ibrahimnasrum/automatic-waste-segregation/Report And Slide/Slide2(Final)_Automatic_Waste_Segregation(INTEGRATED_DESIGN_PROJECT).pdf

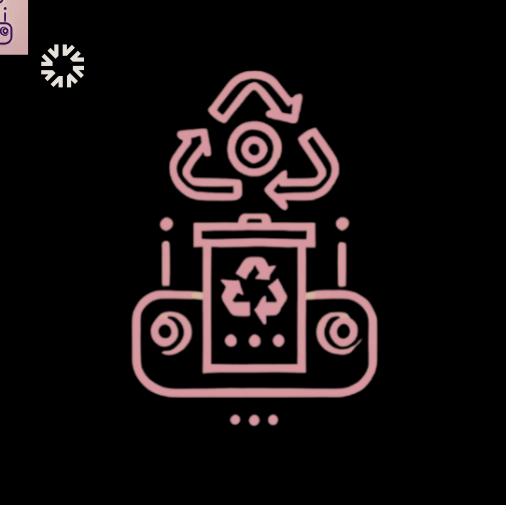
[picture p59: figure]
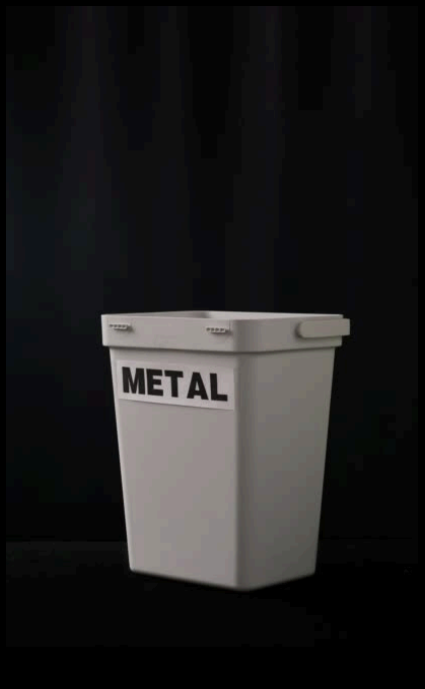
[picture p60: figure]

### Present by: Ibrahim Bin Nasrum (2116467) Almasri Suhail Jihad (2128771) Ahmad Zarady Bin Zulkefly (2111837) Abdallah Mahamat Abacar Maeyd (2117777)

# AUTOMATIC

# WASTE SEGREGATION

## WHAT IS AUTOMATIC WASTE SEGREGATION?

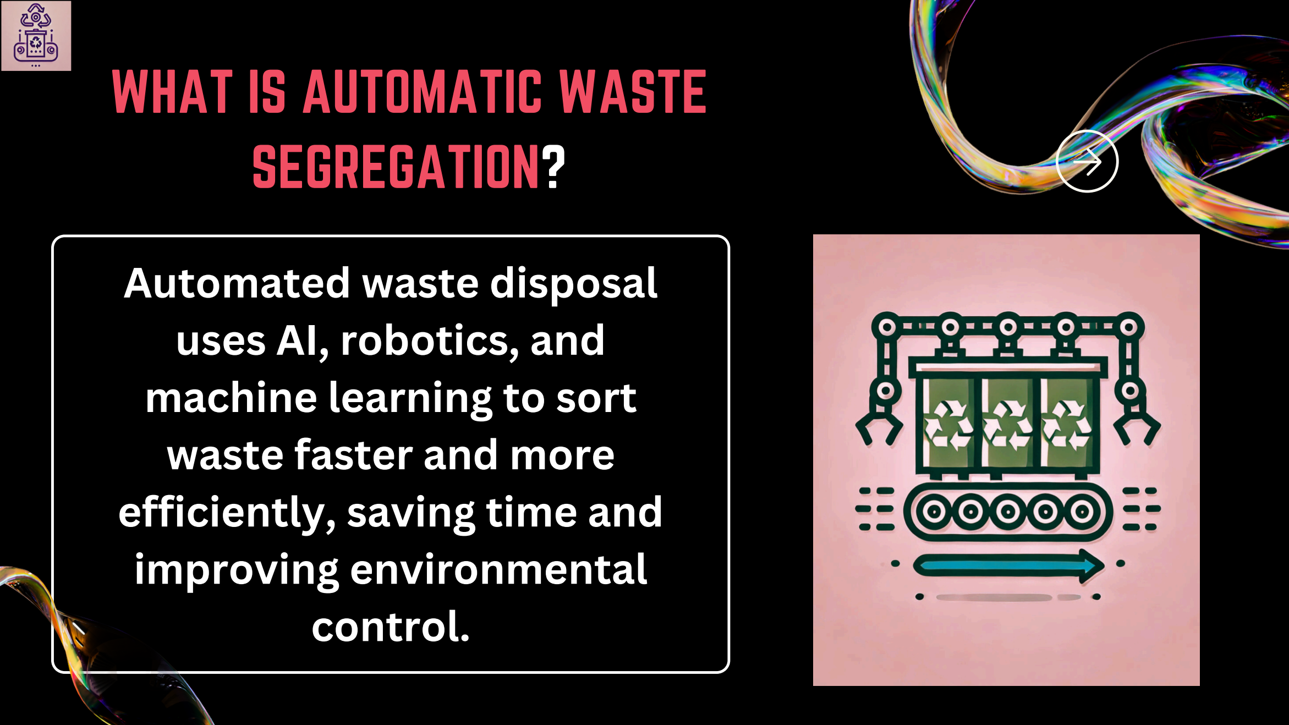
[picture p61: page 2]

### Automated waste disposal uses AI, robotics, and machine learning to sort waste faster and more efficiently, saving time and improving environmental

control.

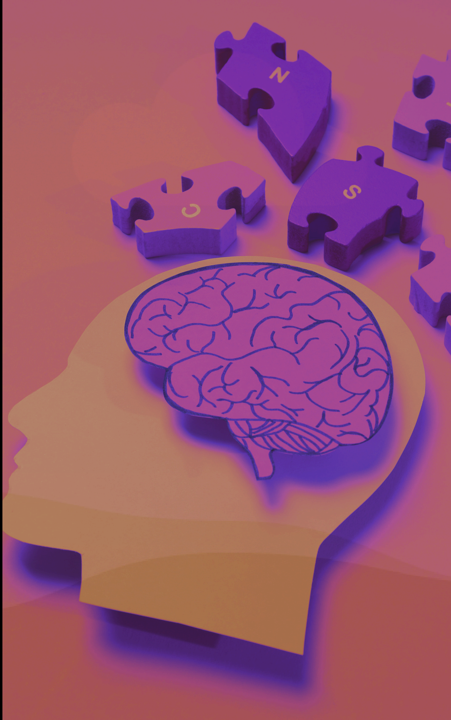
[picture p62: figure]

# Problem Statement

### Public places need an automated waste segregation system to reduce pollution, improve recycling, and lower waste management costs by accurately sorting materials while

minimizing labor and errors.

# Objectives

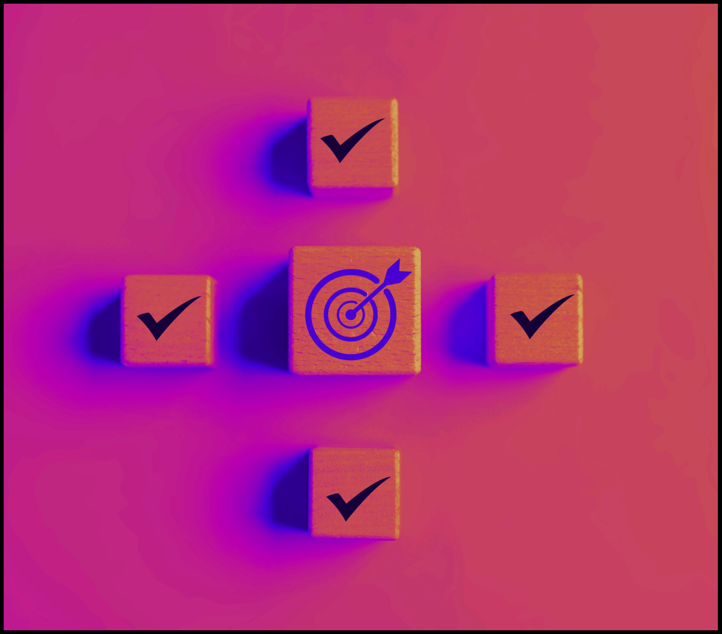
[picture p63: figure]

To design a machine that can segregate recycled waste (Paper, glass, plastic, and metal) in minimizing the manual efforts of sorting.

01

### 02 To evaluate performance of the

machine

02

# Customer survey

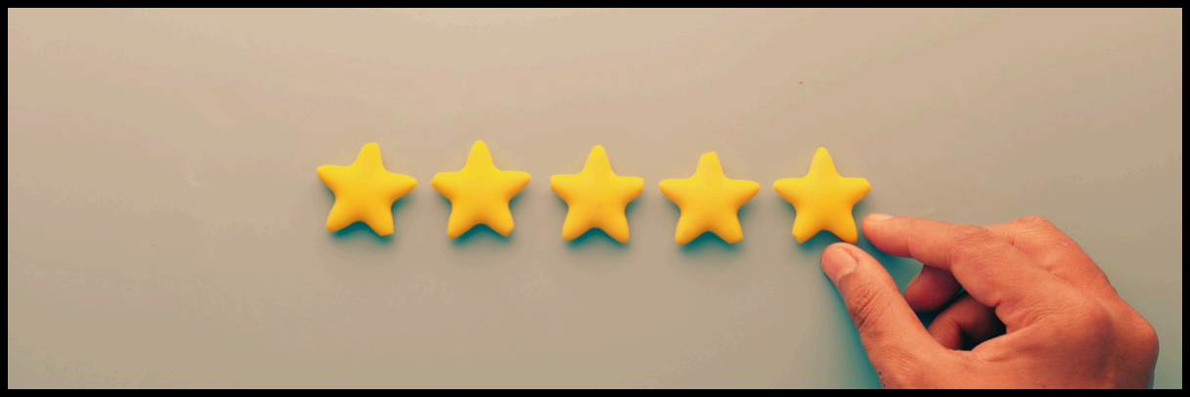
[picture p64: figure]

This survey focuses on target market, waste type, segregation frequency, segregation challenges, difficult waste types, automation importance, accuracy
expectations, space availability, investment willingness, user intervention, real-time feedback, and open feedback

Who is answing this survey?
What type of waste do you primarily generate? How often do you deal with waste segregation or disposal?
If you do segregate waste, what challenges do you face?
Which types of waste are the most challenging for you to segregate?
How important is it for you to have an automated system that can handle multiple types of waste simultaneously? What level of accuracy do you expect from an automatic waste segregation system in correctly sorting different waste types?

How much are you willing to invest in an automated waste segregation system?

How much space do you have available for an automated waste segregation system?

## Some of the questions

# Customer survey

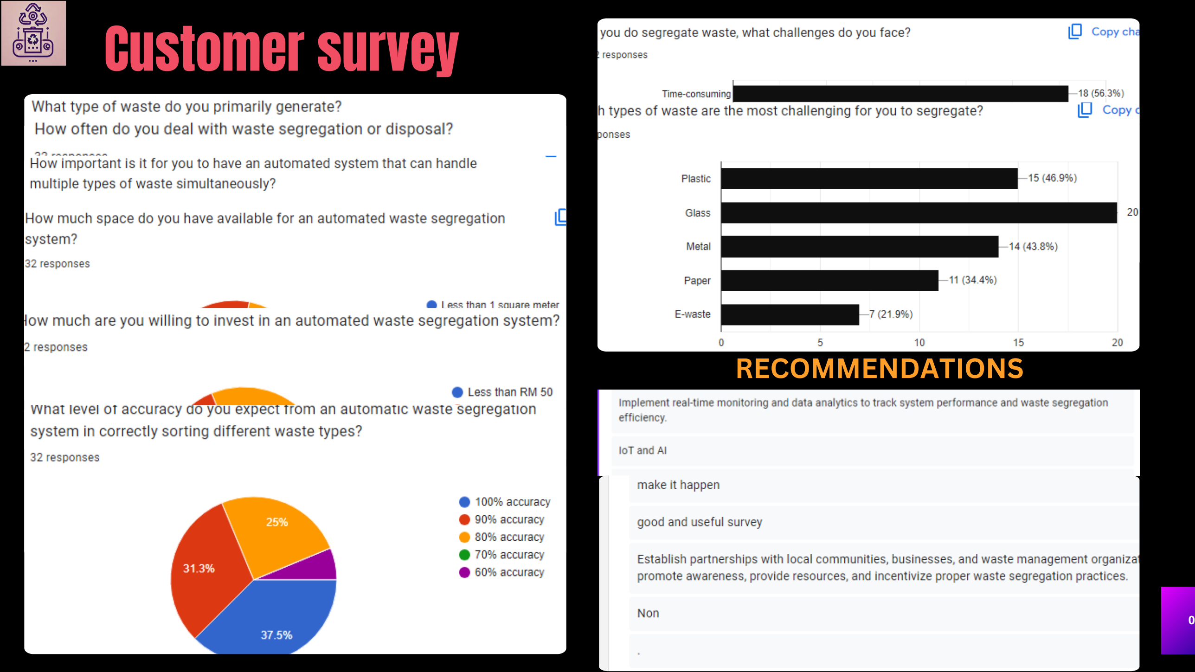
[picture p65: page 6]

0

RECOMMENDATIONS

# Design of The System

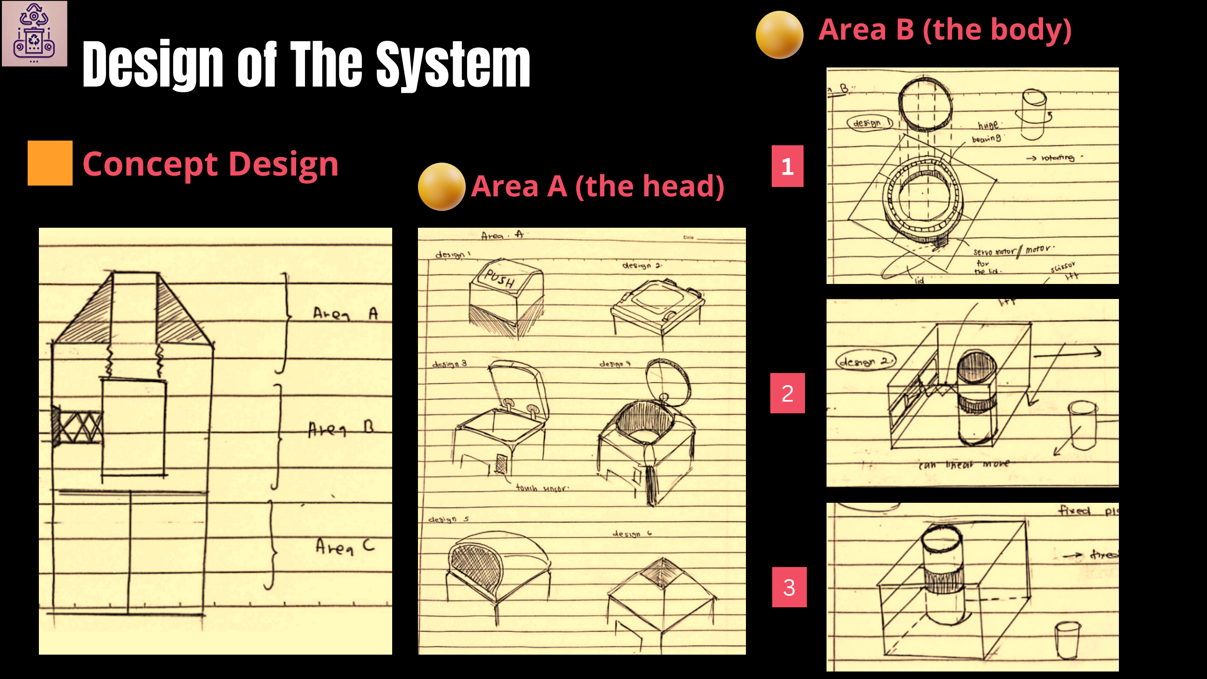
[picture p66: page 7]

### Concept Design

Area B (the body)

Area A (the head)

1

2

3

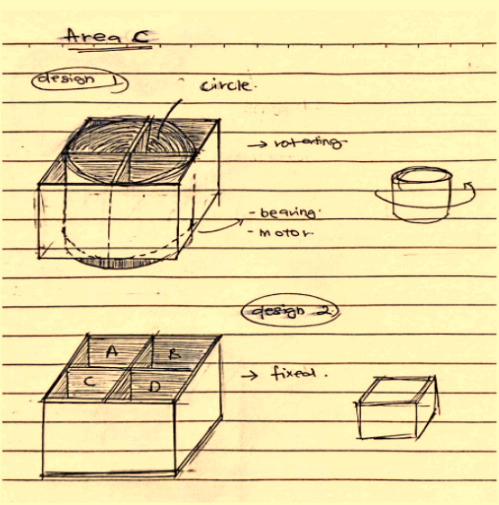
[picture p67: figure]

1

2

# Design of The System

### Area C (the body)

First Combination (Design 1 ) : Area B: Design 2 (linear movement mechanism similar to a 3D printer) Area C: Design 2 (fixed compartments) Second Combination (Design 2 ): Area B: Design 3 (fixed cylinder)
Area C: Design 1 (rotating compartments with bearing and motor)
Third Combination (Design 3 ): Area B: Design 1 (rotating mechanism with servo motor)
Area C: Design 2 (fixed compartments)

### Our chosen design is 1 based on Pugh Chart method

# FINALIZED PRODUCT

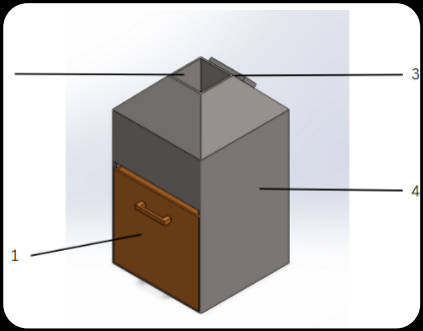
[picture p68: figure]

1 frame

2 Storage Box

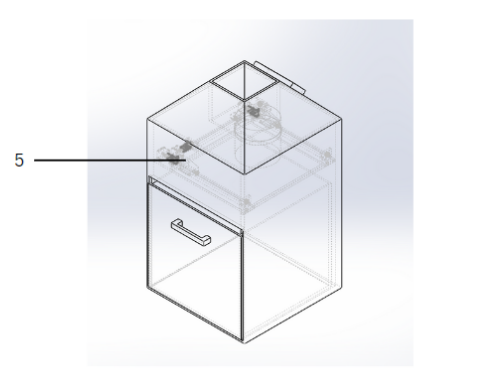
[picture p69: figure]

3 | Segregate Mechanism

4 Input Hopper

5 User Interface Section

# FINALIZED PRODUCT

# MAIN FRAME

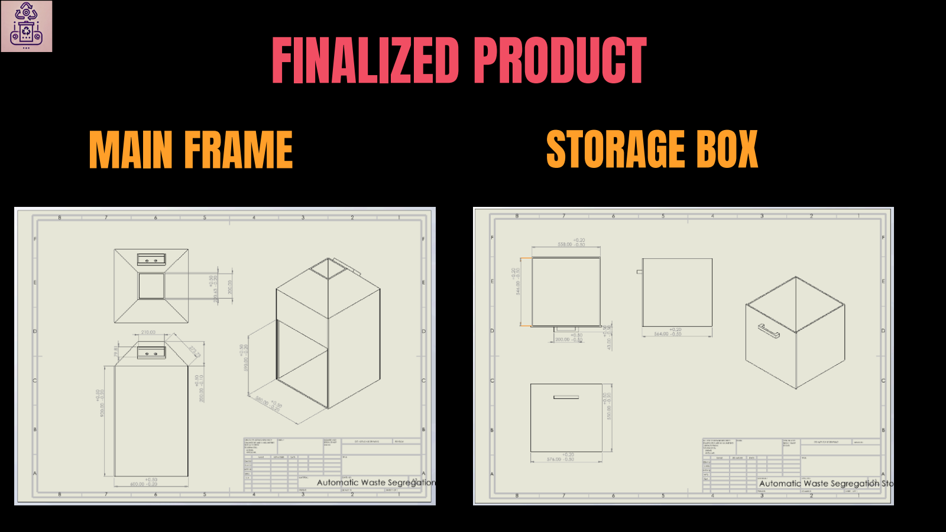
[picture p70: page 10]

# STORAGE BOX

# FINALIZED PRODUCT

# SEGREGATE MECHANISM

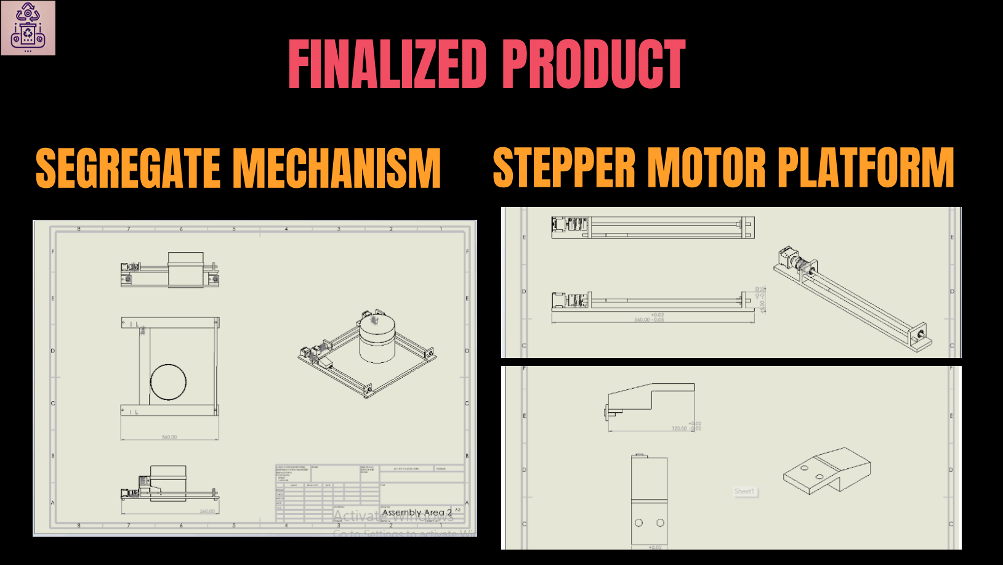
[picture p71: page 11]

# STEPPER MOTOR PLATFORM

# LIST ITEM

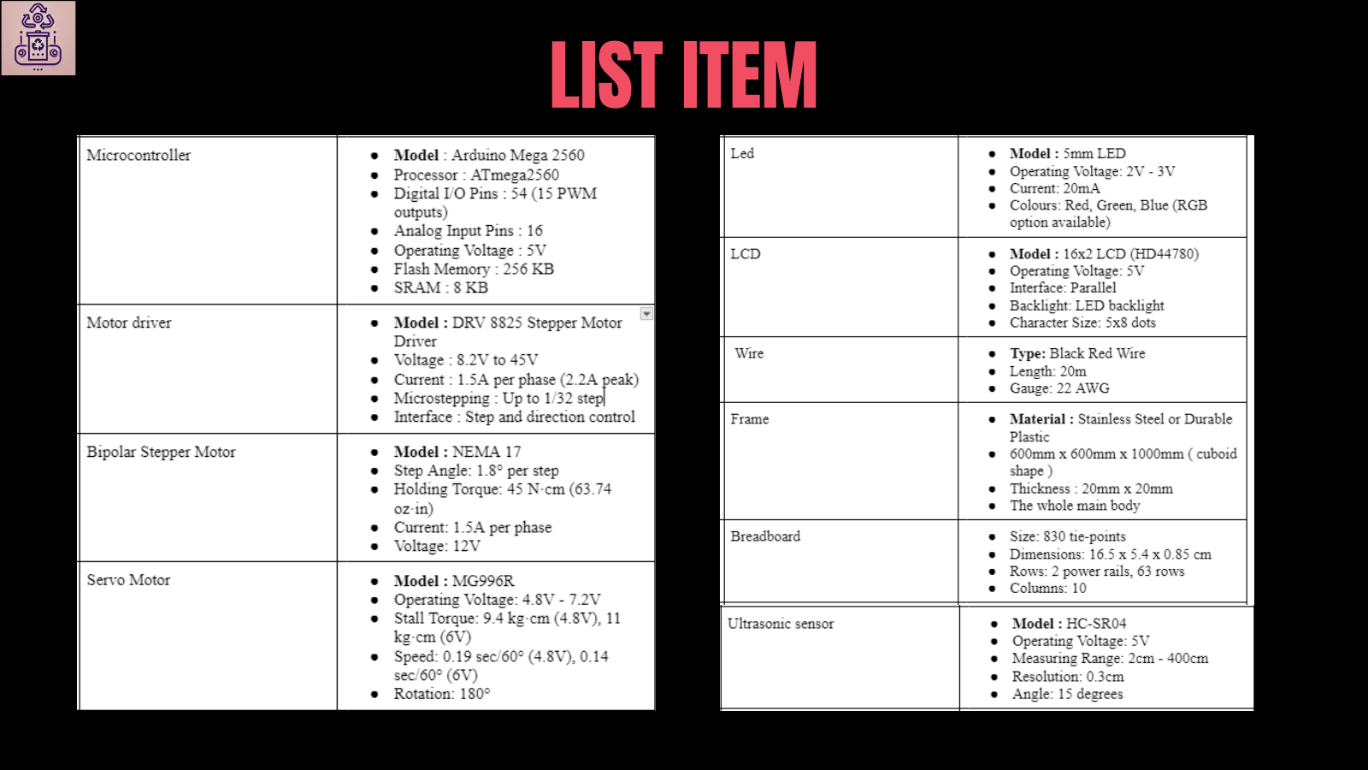
[picture p72: page 12]

# LIST ITEM

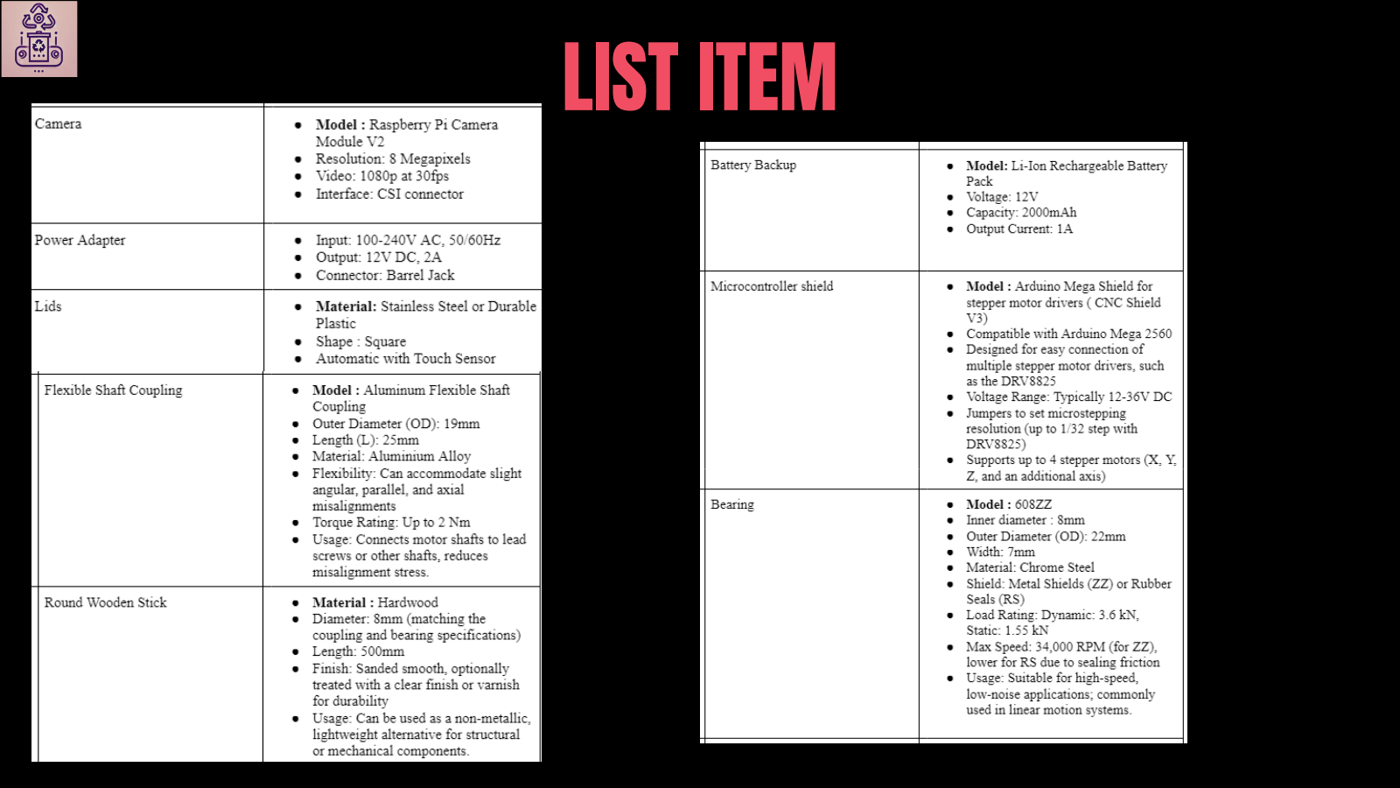
[picture p73: page 13]

# system progression

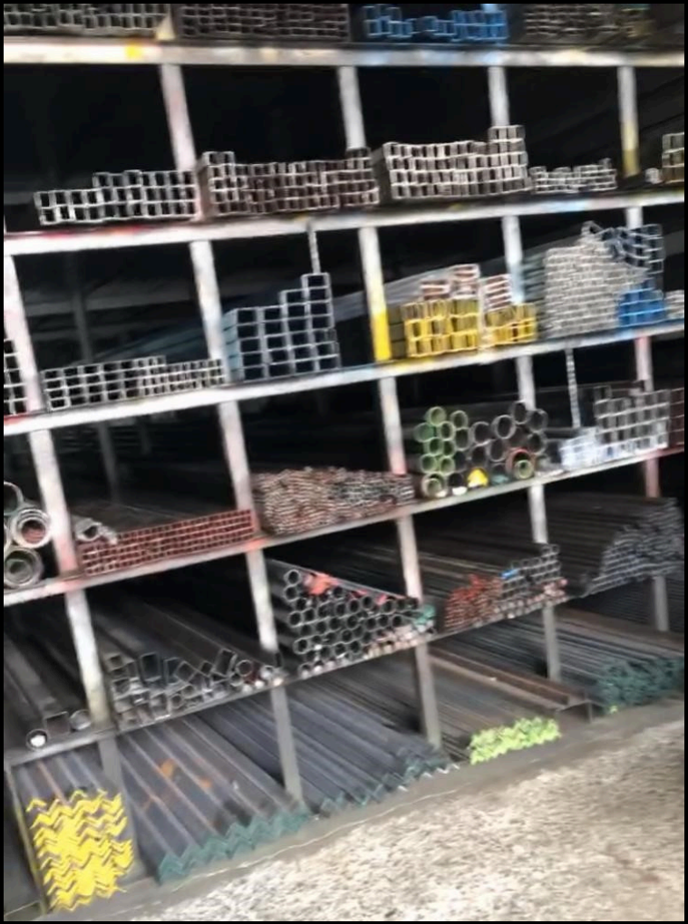
[picture p74: figure]

# 1. Frame

## Material: Stainless Steel 600mm x 600mm x 1000mm ( cuboid shape ) Thickness : 30mm x 30mm The whole main body

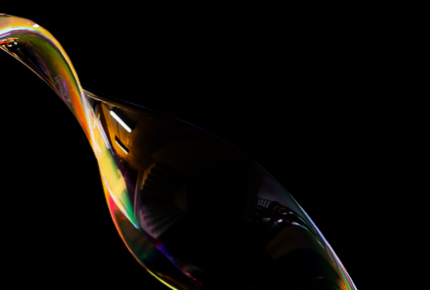
[picture p75: figure]

# system progression

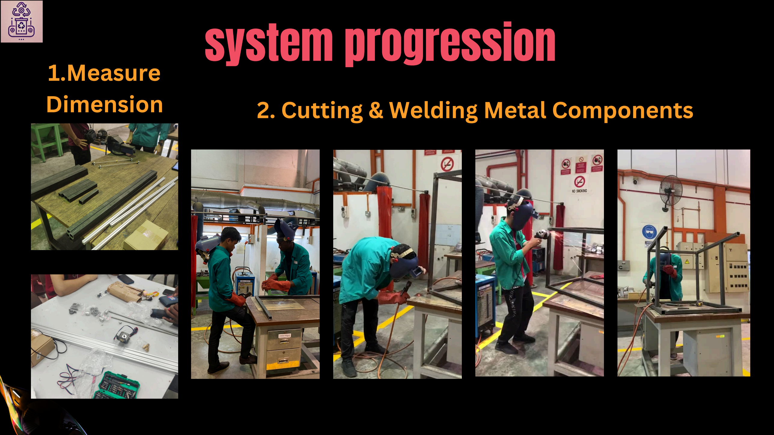
[picture p76: page 15]

1.Measure
Dimension

### 2. Cutting & Welding Metal Components

# system progression

# 2. 3d printing Process

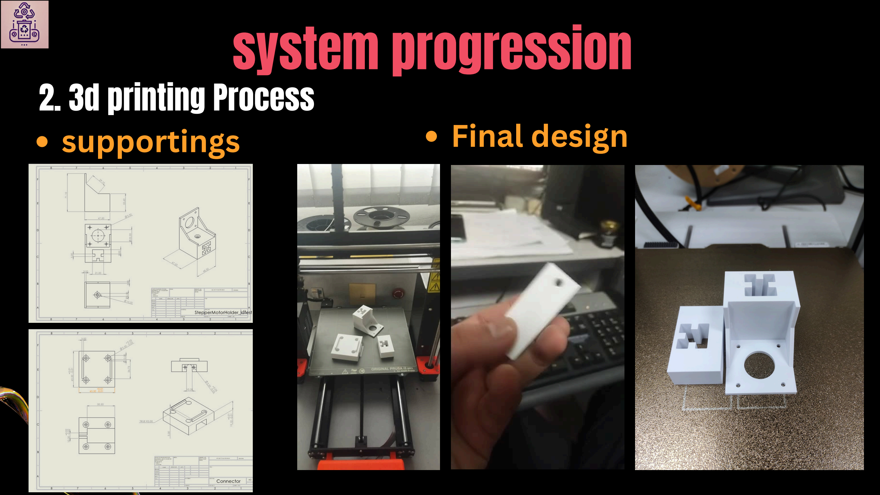
[picture p77: page 16]

supportings | Final design

# system progression

## 3. Segregation Mechanism

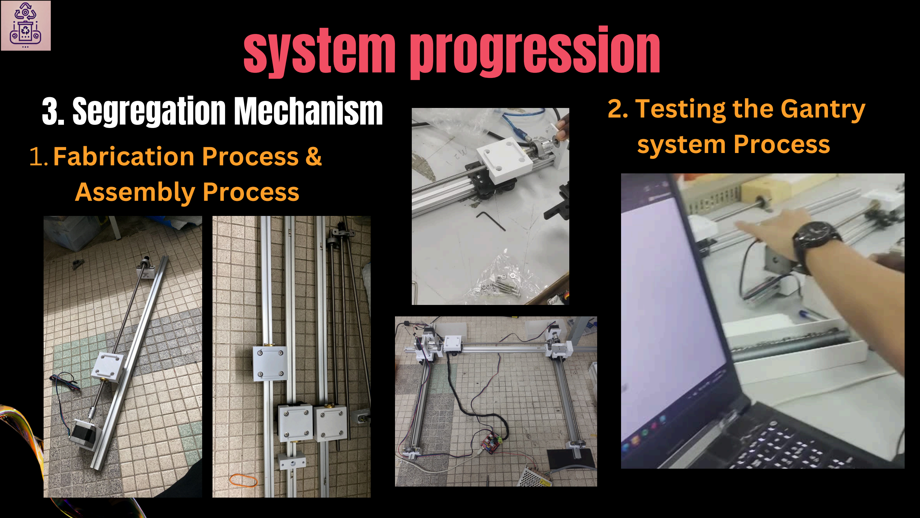
[picture p78: page 17]

1.Fabrication Process &
Assembly Process

### 2. Testing the Gantry

system Process

# Calculation

## 1. Load and Torque Calculation

Key Considerations:
1.Motor Specifications:
Torque rating of the NEMA 17 stepper motors (typically 0.4–0.5 Nm for standard models at rated current).
Current and voltage supplied by the driver.
2.Mechanical Characteristics: Lead screw pitch or belt pitch (linear movement per motor revolution). Friction and efficiency of the guide rails and transmission system.
3.System Configuration:
Total load supported by Motor C (including its own weight, load, and frame). Torque distribution on Motors A and B if they share the load.
4.Load Movement Steps:
Total steps to cover 5000 steps (as specified).

# Calculation

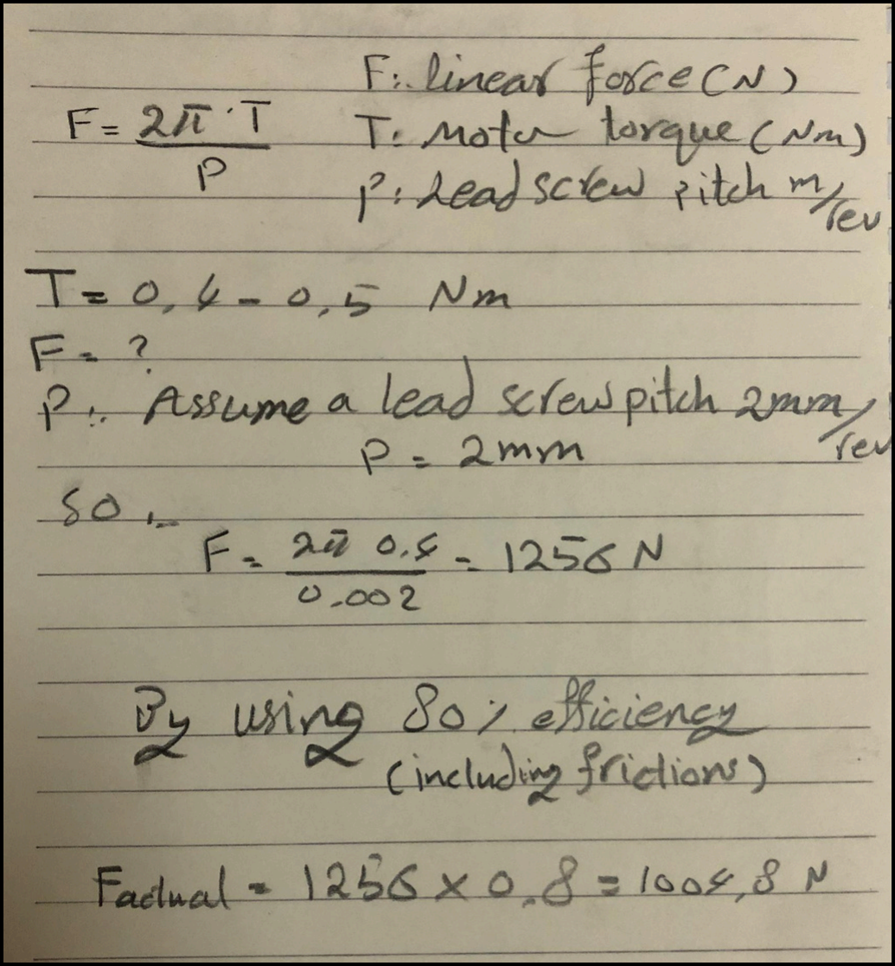
[picture p79: figure]

Using the relationship
between torque and linear
force on the leadscrew.

The theoretical
maximum force is
applied by each motor
before friction and
efficiency losses.

## Maximum focce

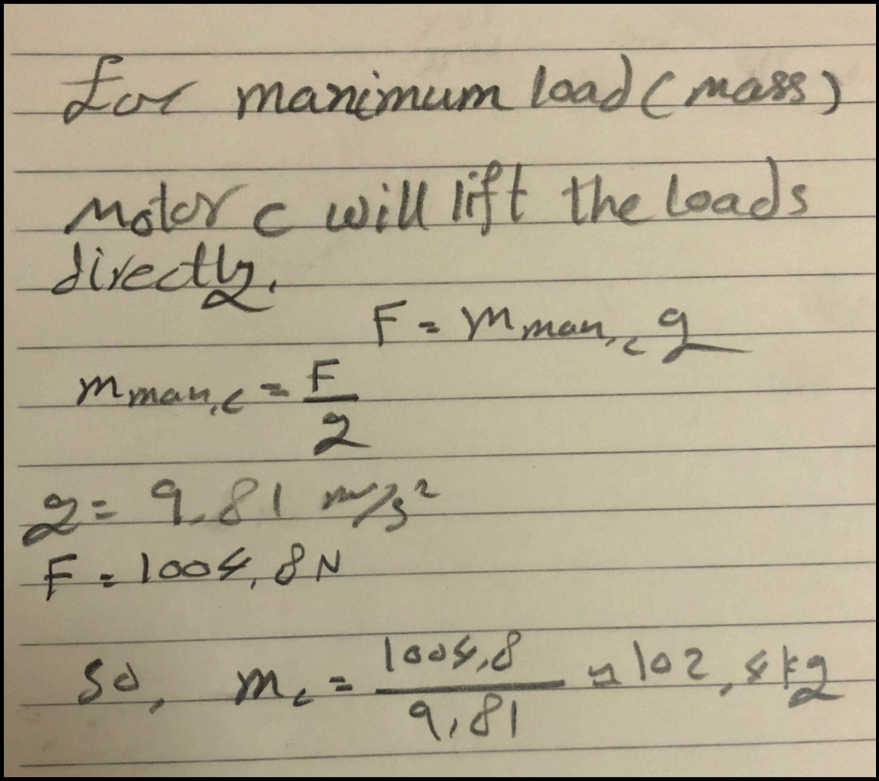
[picture p80: figure]

If Motor C carries a smaller load (e.g., less than 102.4 kg), the total capacity
increases slightly.

## Maximum mass

# Calculation

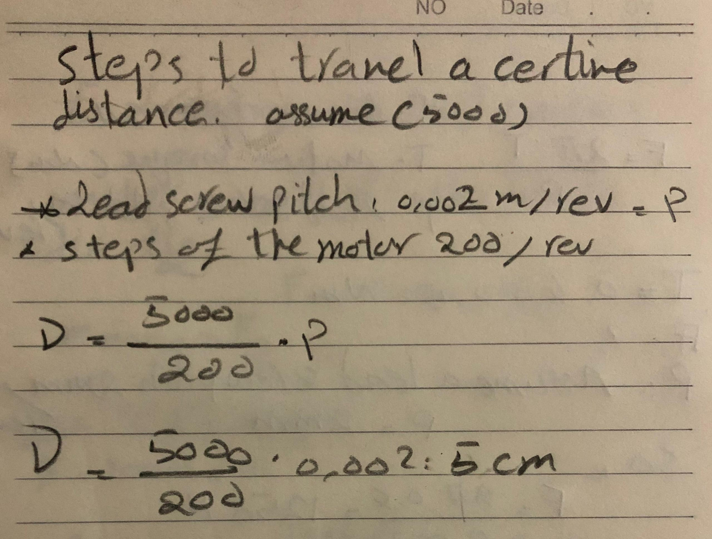
[picture p81: figure]

Steps for a Require
Travelling

assume (5000) steps

## distance calculation

# Calculation

# Calculation

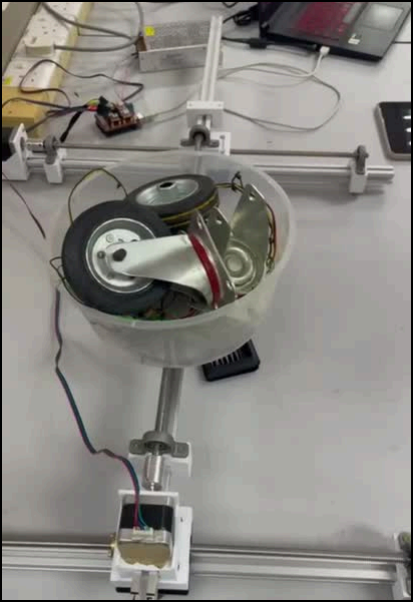
[picture p82: figure]

# testing 6kg of mass

# Machine Learning

### Image Classification Using ML.NET in Visual Studio 2022 for Image Classification

### FLOW

Mechanical
Parts

Preparing
data set

Train Data
Set

Evaluate
Performance

# Machine Learning

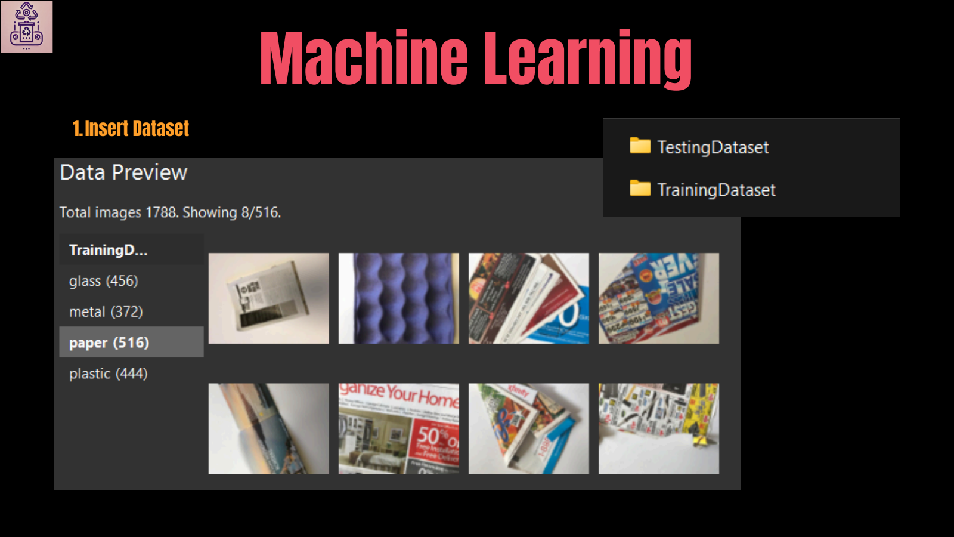
[picture p83: page 24]

1.Insert Dataset

# Machine Learning

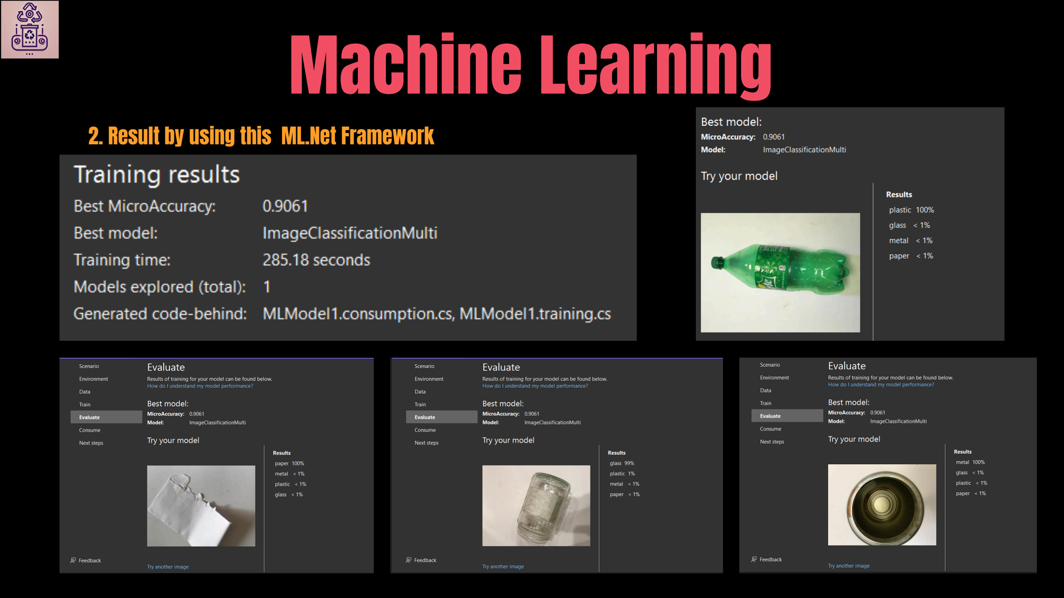
[picture p84: page 25]

### 2. Result by using this ML.Net Framework

# Machine Learning

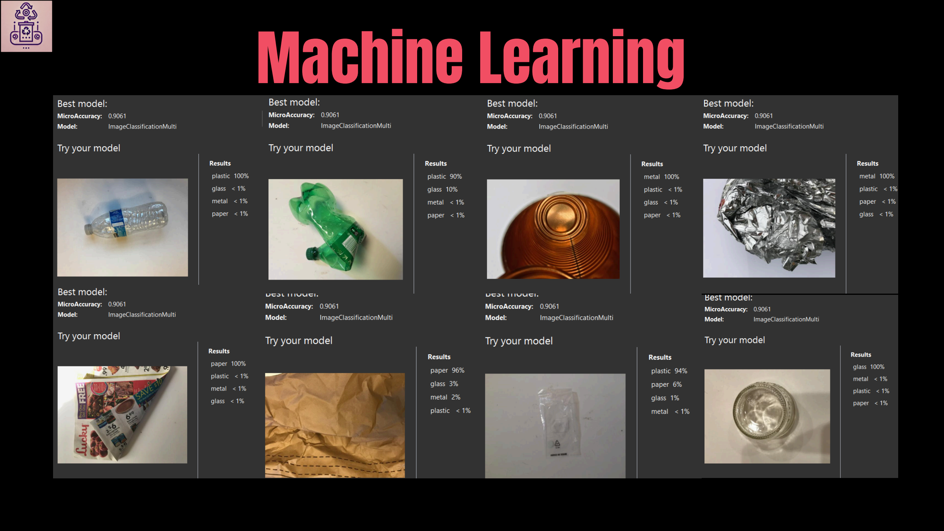
[picture p85: page 26]

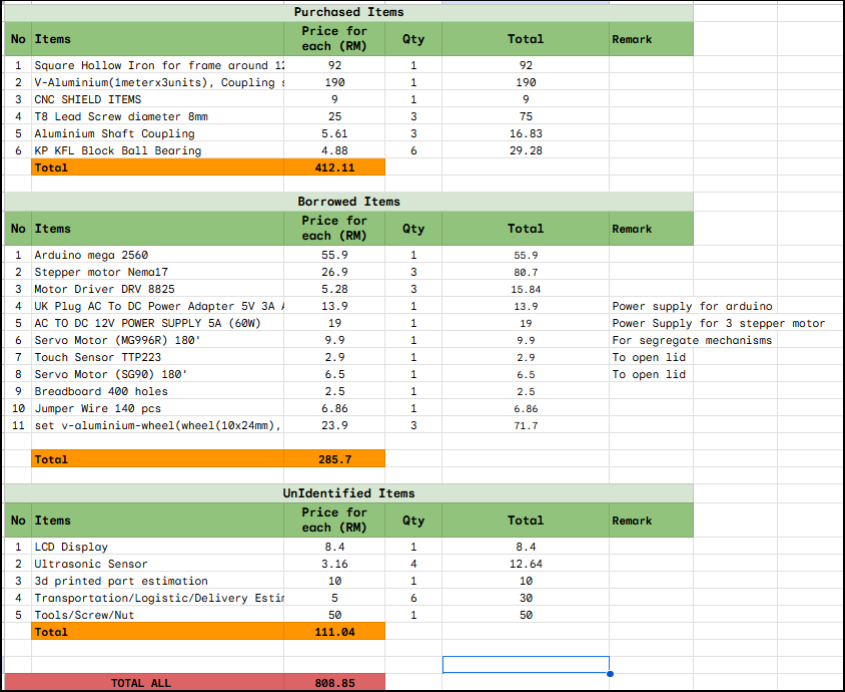
[picture p86: figure]

# COSTING

## TOTAL COST:

RM 808.85

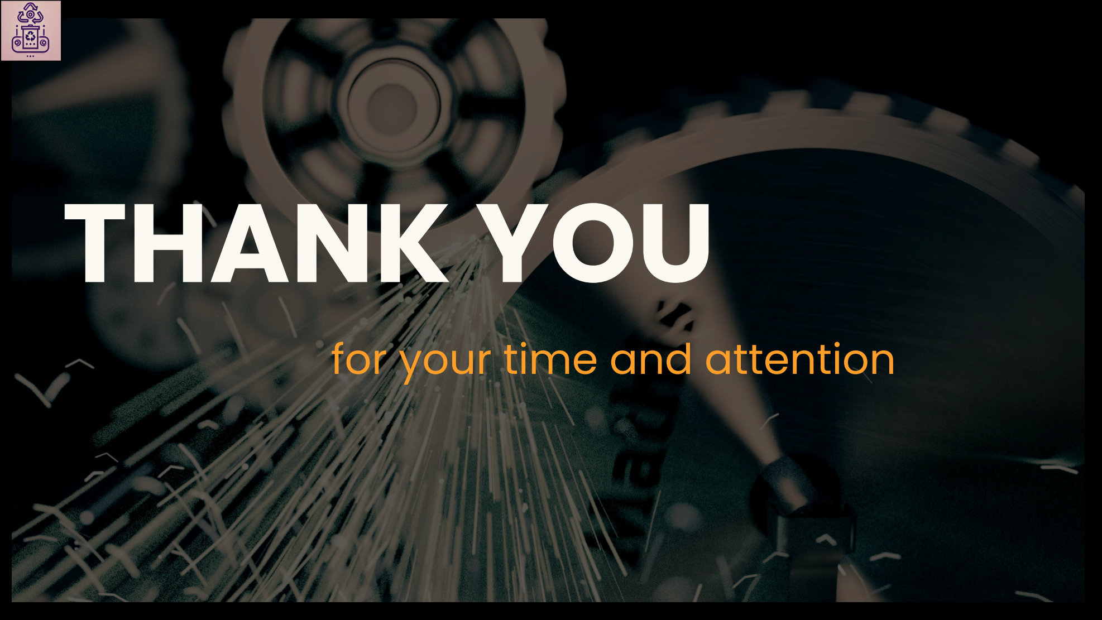
[picture p87: page 28]

# THANK YOU

# for your time and attention
