ibrahimnasrum/automatic-waste-segregation/Report And Slide/Slide 1_Automatic_Waste_Segregation(INTEGRATED_DESIGN_PROJECT.pdf

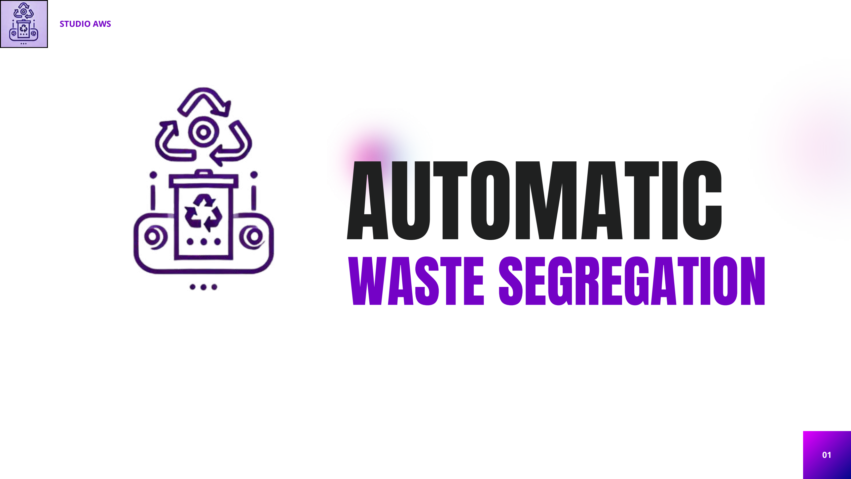
[picture p88: page 1]

# AUTOMATIC

# WASTE SEGREGATION

### STUDIO AWS

01

# About Automatic

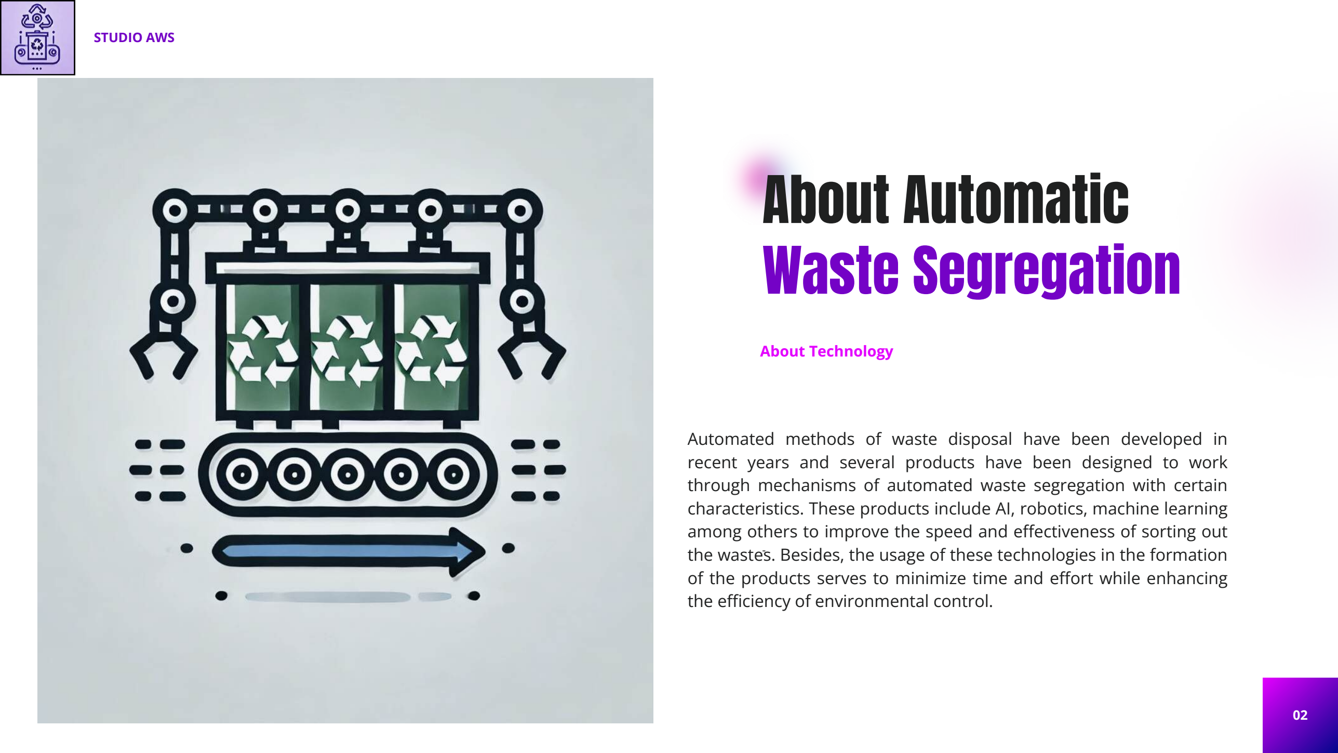
[picture p89: page 2]

02

# Waste Segregation

Automated methods of waste disposal have been developed in recent years and several products have been designed to work through mechanisms of automated waste segregation with certain characteristics. These products include AI, robotics, machine learning among others to improve the speed and effectiveness of sorting out the wastes. Besides, the usage of these technologies in the formation of the products serves to minimize time and effort while enhancing

the efficiency of environmental control.

## About Technology

Home | Service | About Us | Contact

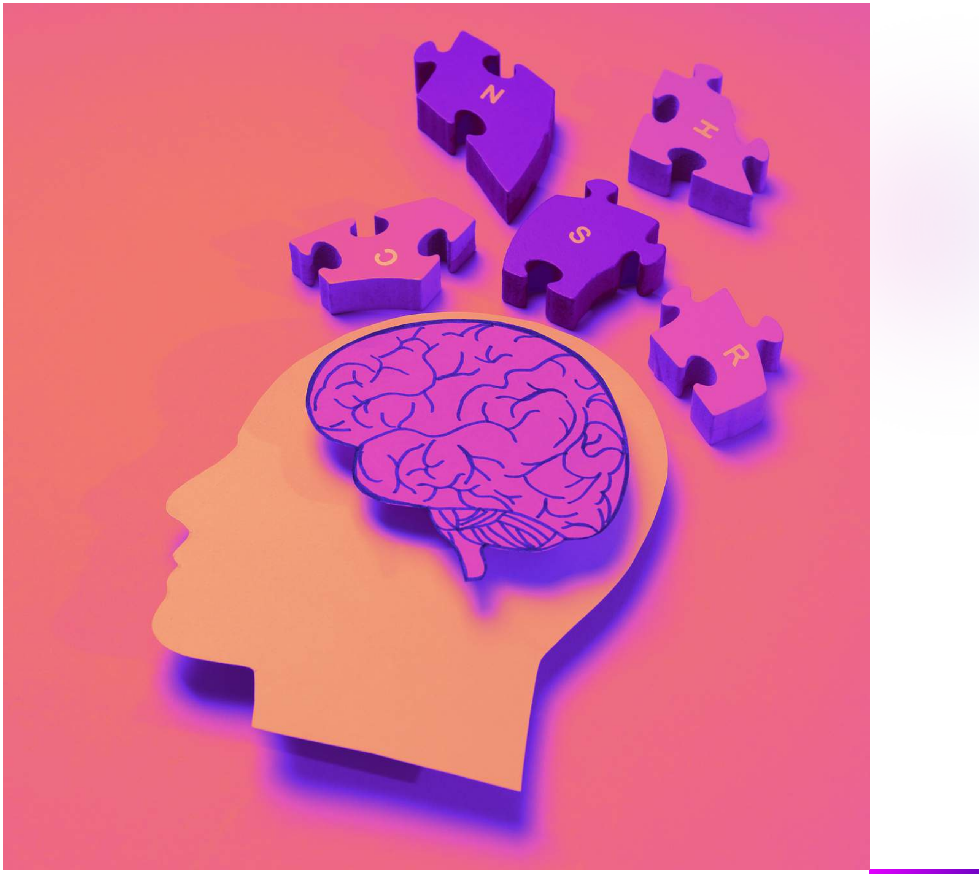
[picture p90: figure]

03

# Problem Statement

## Public places need an efficient and effective way to manage and segregate waste because improper waste segregation in high-

traffic areas leads to increased environmental pollution,

## decreased recycling efficiency, and higher waste management costs. Manual sorting of waste in public spaces is often labour-

intensive, prone to errors, and can be unhygienic for workers.

## An automated waste segregation system designed for public use can address these issues by accurately sorting recyclable materials like metals, plastics, glass, and paper, thereby promoting sustainable waste management practices and reducing the operational burden on public maintenance

services.

Home | Service | About Us | Contact

04

# Objectives

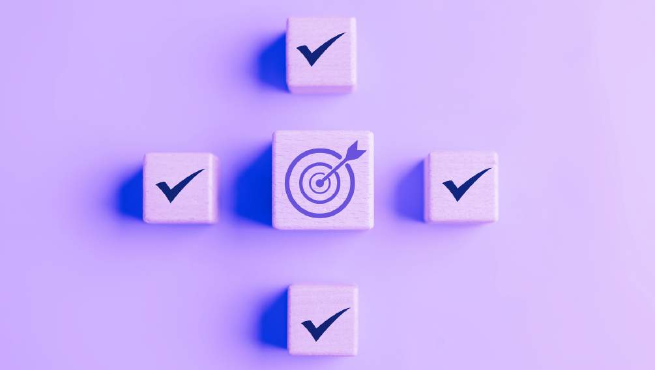
[picture p91: figure]

## To design a machine that can segregate recycled waste (Paper, glass, plastic, and metal) to

minimize the manual efforts of sorting.

01

02

## To evaluate performance of the machine

02

# CUSTOMER SURVEY

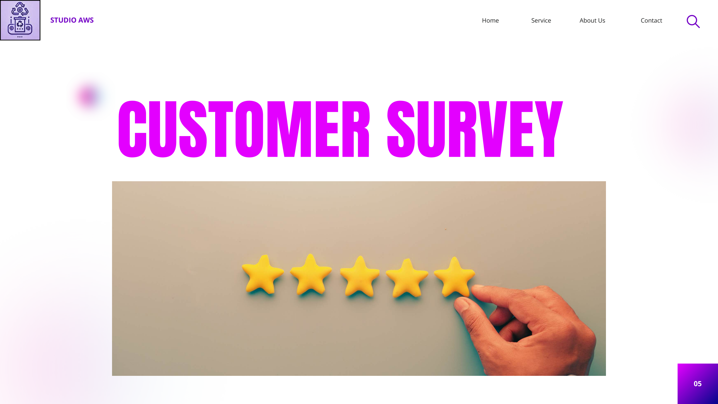
[picture p92: page 5]

Home | Service | About Us | Contact

05

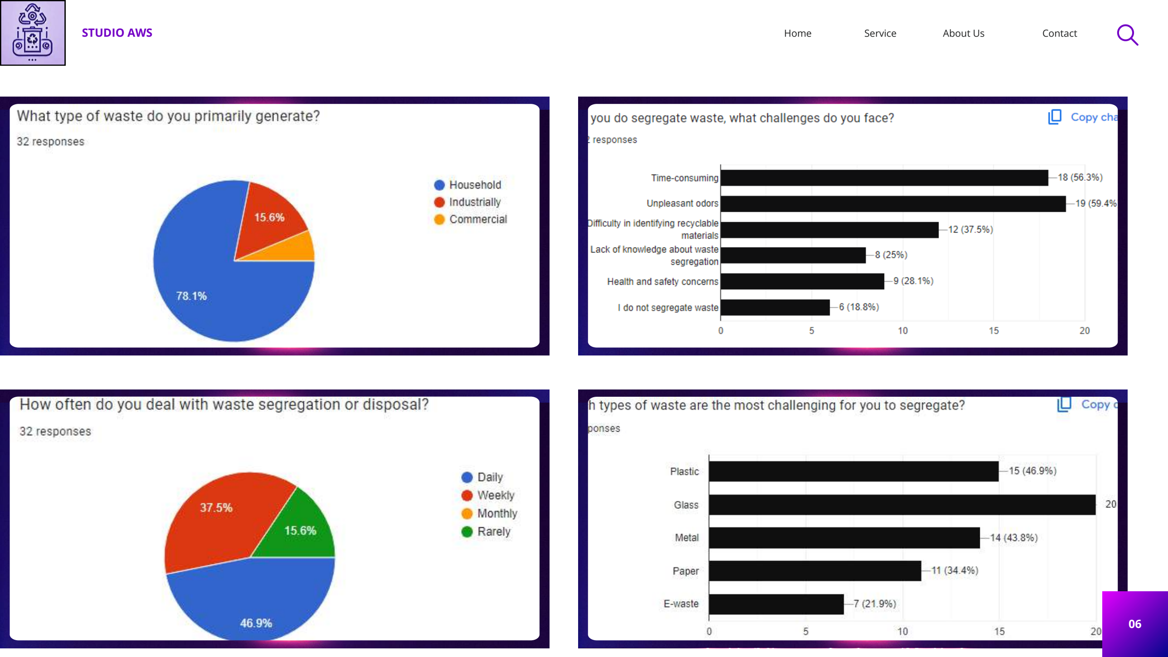
[picture p93: page 6]

STUDIO AWS | Home | Service | About Us | Contact

06

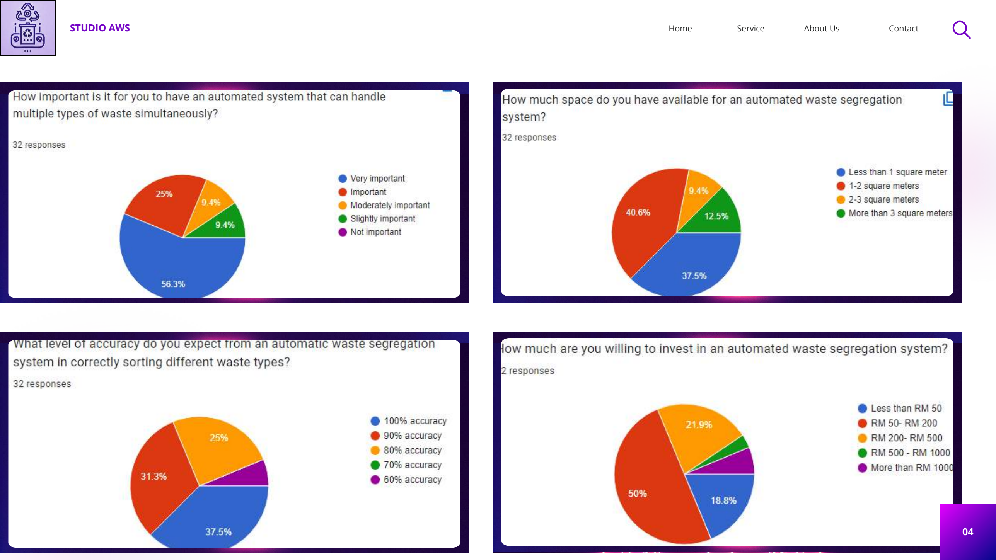
[picture p94: page 7]

STUDIO AWS | Home | Service | About Us | Contact

04

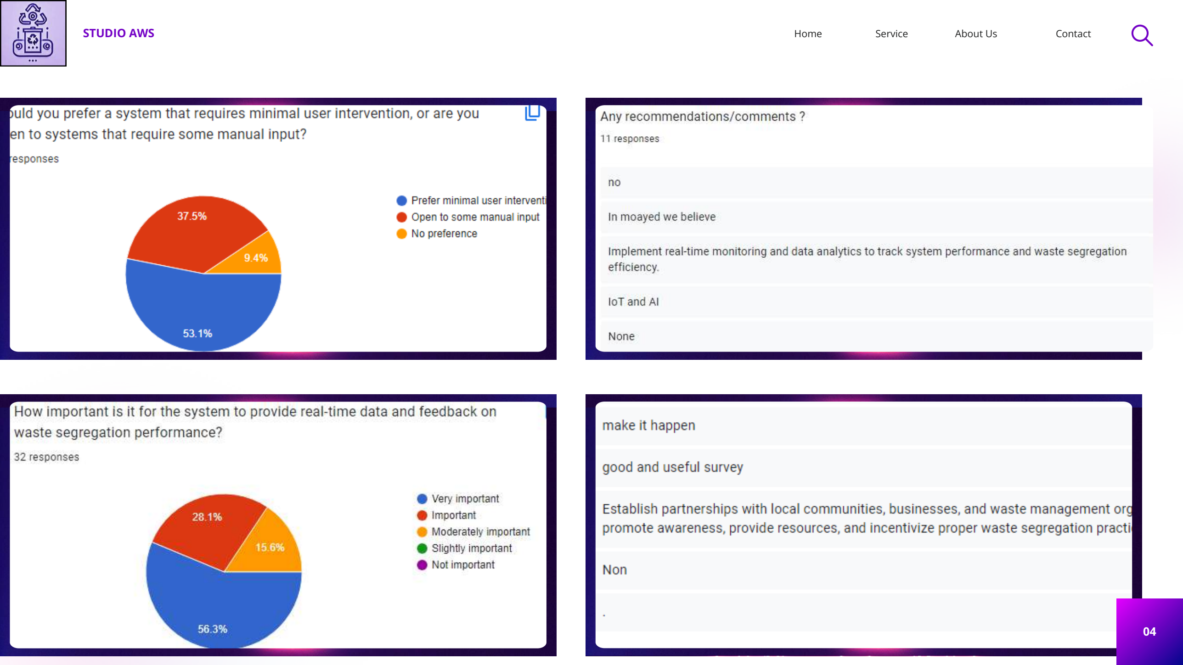
[picture p95: page 8]

STUDIO AWS | Home | Service | About Us | Contact

04

# Design of The System

# Concept Design

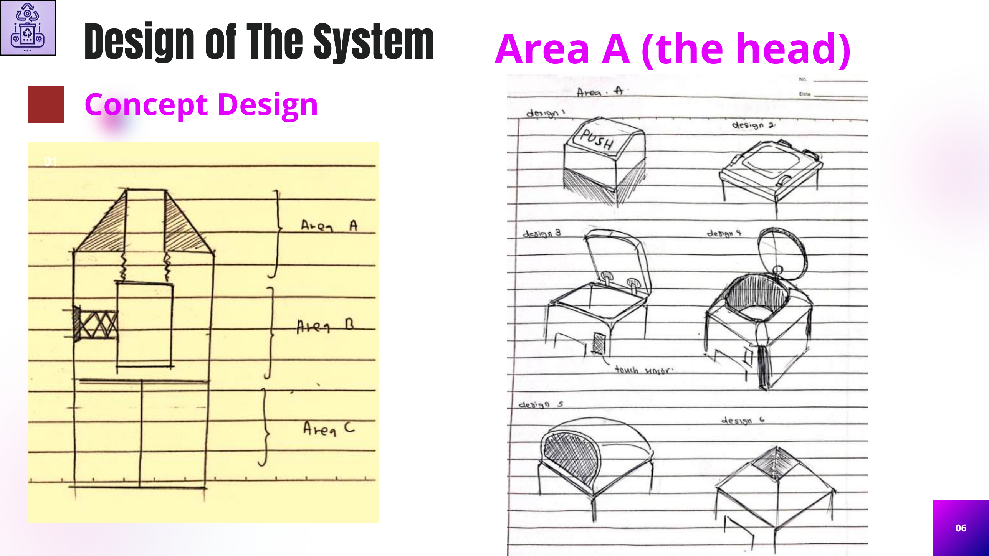
[picture p96: page 9]

06

01

# Area A (the head)

2

# Design of The System

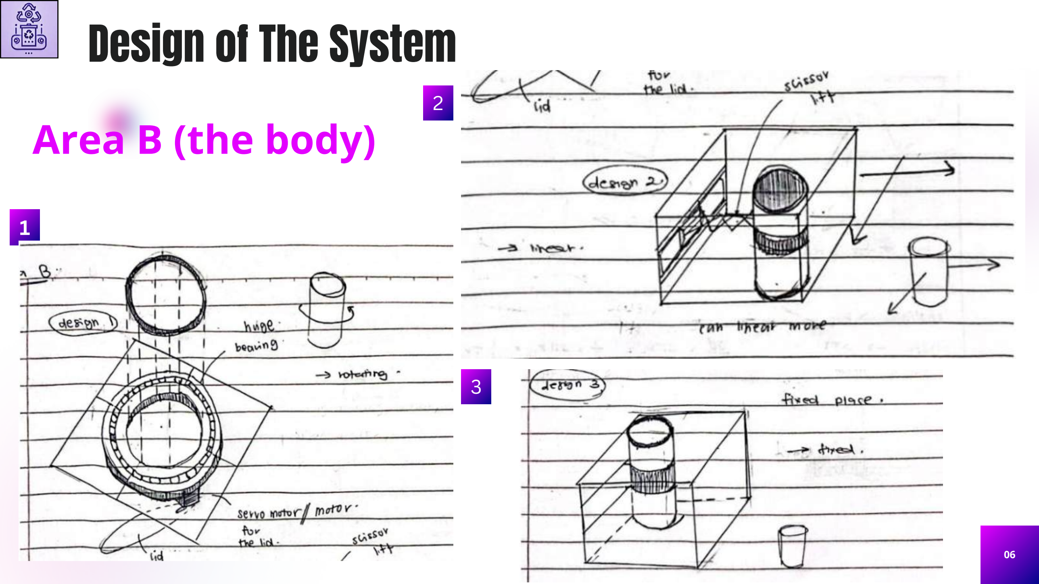
[picture p97: page 10]

1

3

06

01

# Area B (the body)

# Design of The System

# Area C (the body)

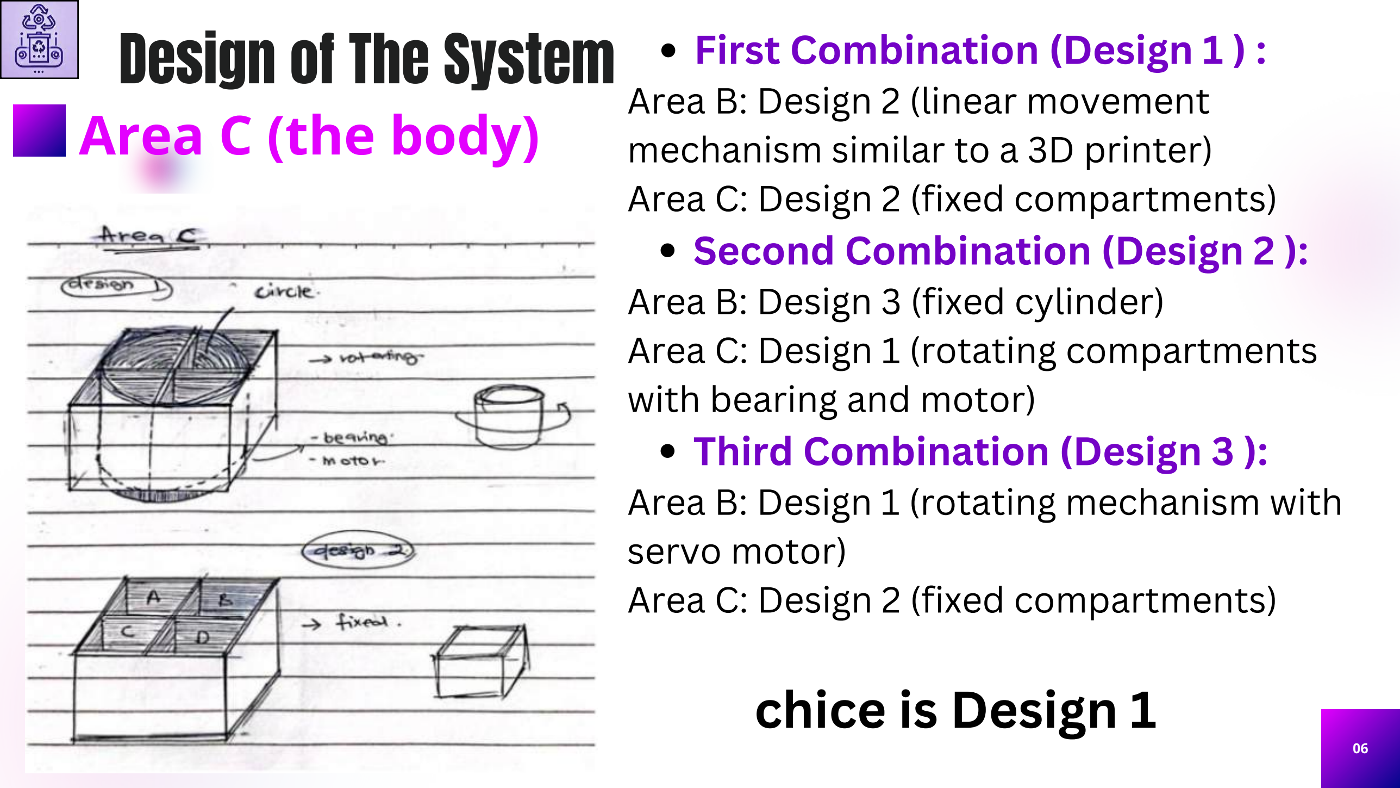
[picture p98: page 11]

06

01

# First Combination (Design 1 ) :

# Area B: Design 2 (linear movement mechanism similar to a 3D printer) Area C: Design 2 (fixed compartments)

# Second Combination (Design 2 ):

# Area B: Design 3 (fixed cylinder) Area C: Design 1 (rotating compartments with bearing and motor)

# Third Combination (Design 3 ):

# Area B: Design 1 (rotating mechanism with servo motor) Area C: Design 2 (fixed compartments)

# chice is Design 1

# FINALIZED PRODUCT

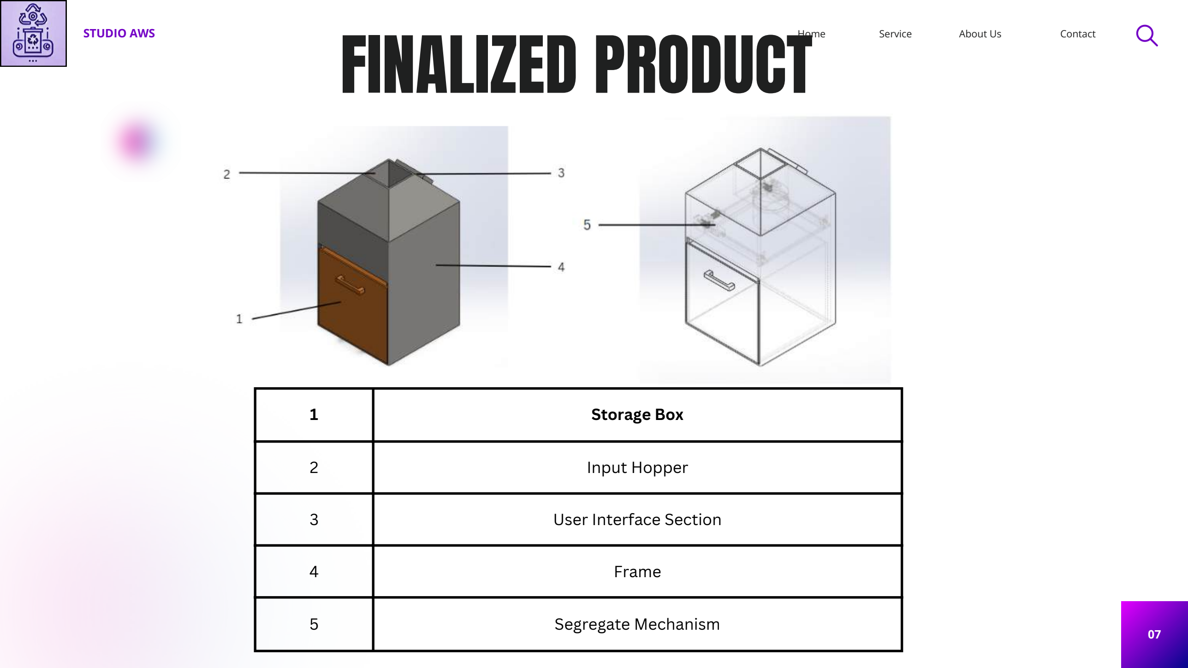
[picture p99: page 12]

Home | Service | About Us | Contact

07

## 1 Storage Box

2 | Input Hopper
3 | User Interface Section
4 | Frame
5 | Segregate Mechanism

Service | About Us | Contact

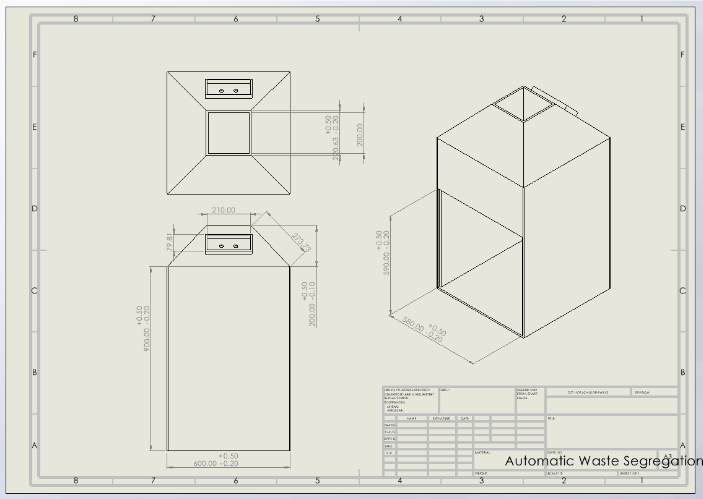
[picture p100: figure]

# MAIN FRAME

# FINALIZED PRODUCT

1.

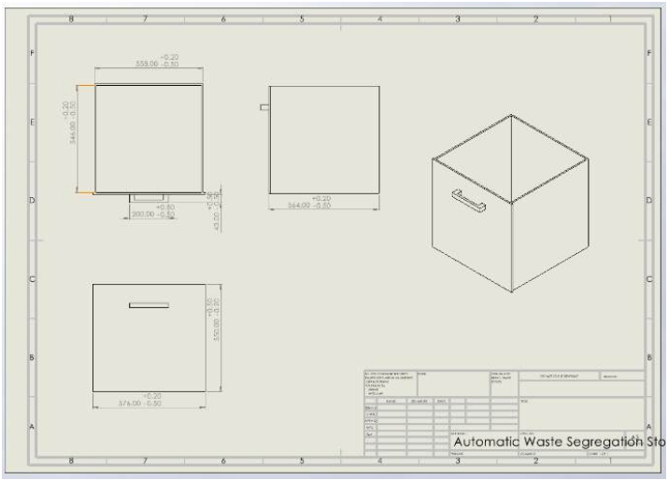
[picture p101: figure]

# STORAGE BOX

# FINALIZED PRODUCT

2.

# SEGREGATE

# FINALIZED PRODUCT

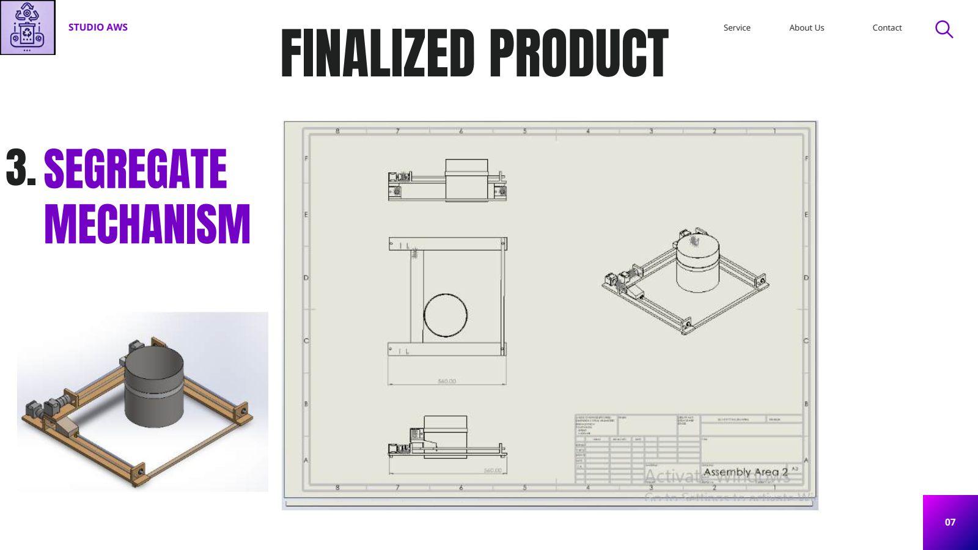
[picture p102: page 15]

# MECHANISM

3.

# STEPPER

# FINALIZED PRODUCT

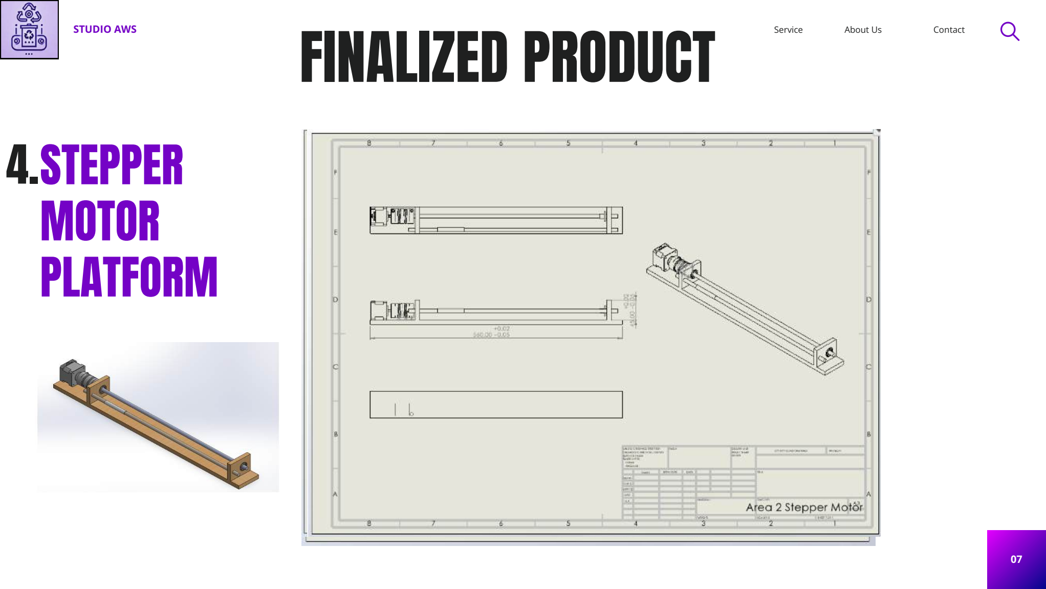
[picture p103: page 16]

# MOTOR PLATFORM

4.

# STEPPER

# FINALIZED PRODUCT

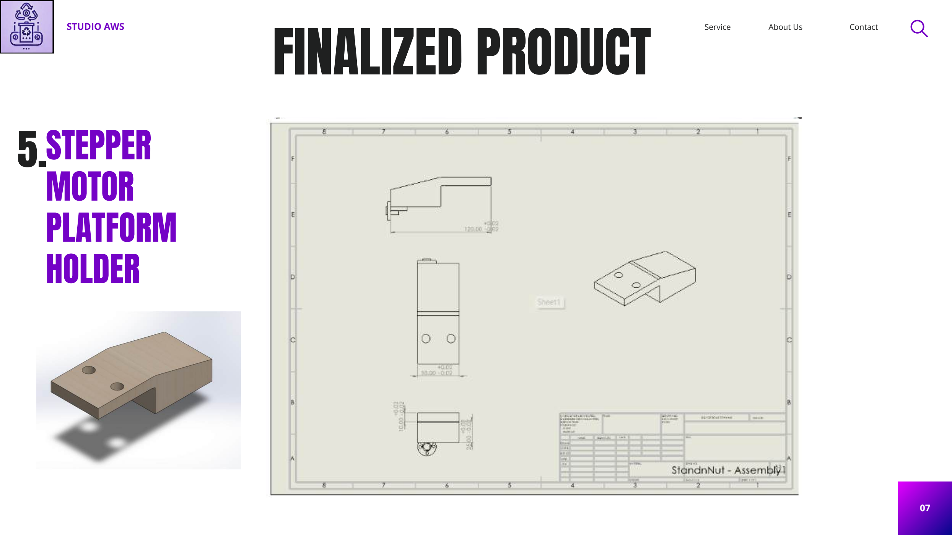
[picture p104: page 17]

# MOTOR PLATFORM HOLDER

5.

# CYLINDER

# FINALIZED PRODUCT

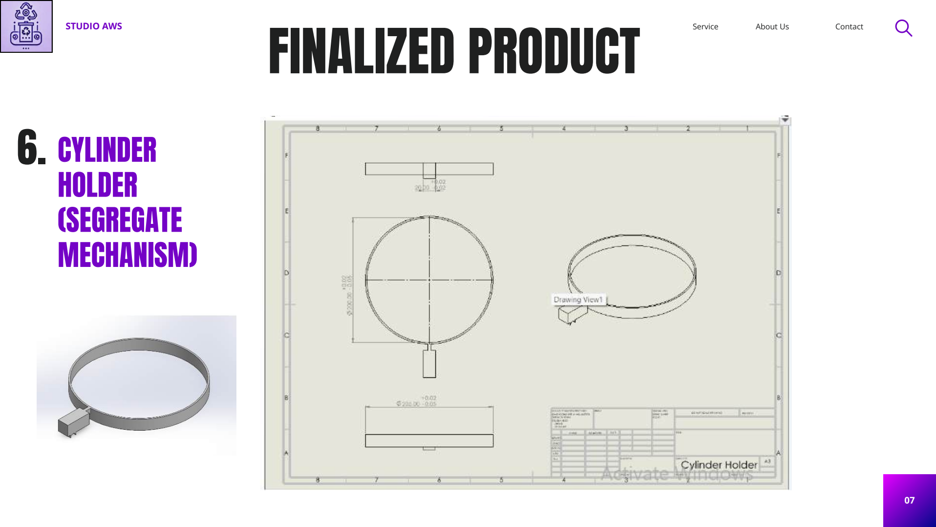
[picture p105: page 18]

# HOLDER (SEGREGATE MECHANISM)

6.

# LIST ITEM

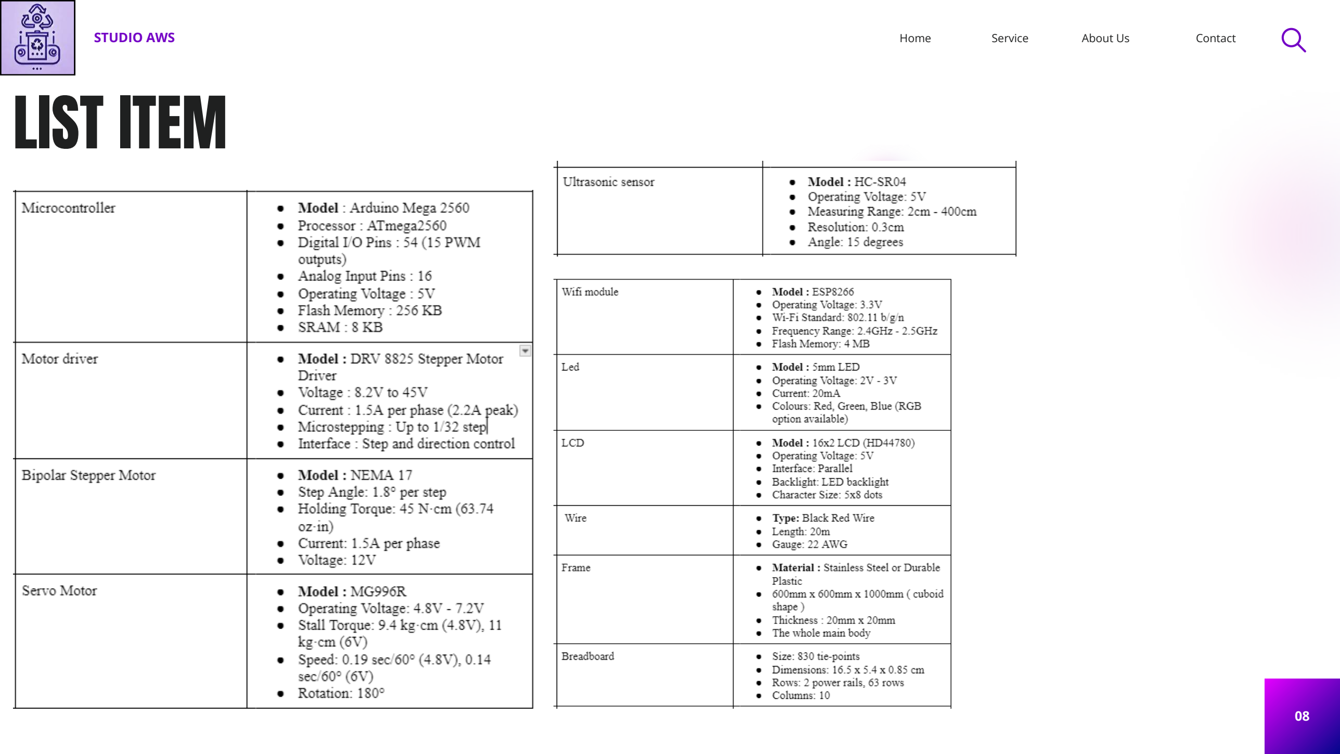
[picture p106: page 19]

Home | Service | About Us | Contact

08

# LIST ITEM

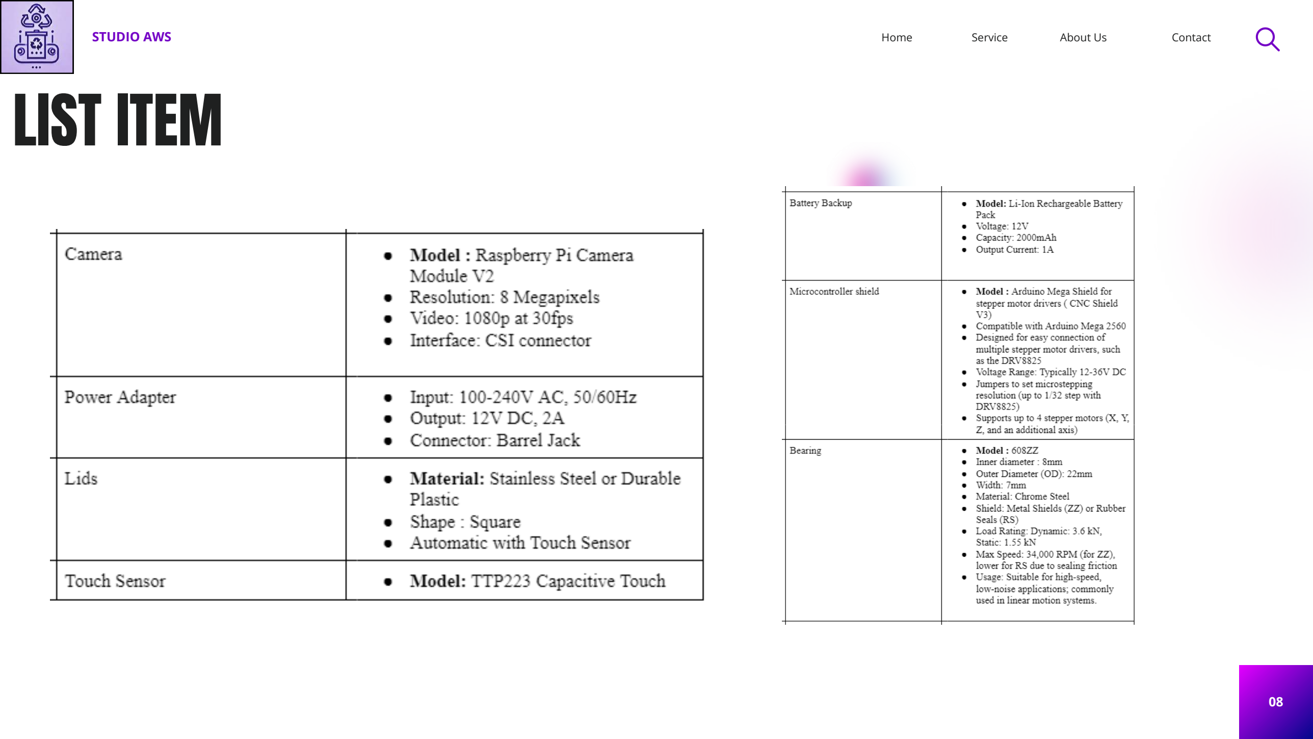
[picture p107: page 20]

Home | Service | About Us | Contact

08

# LIST ITEM

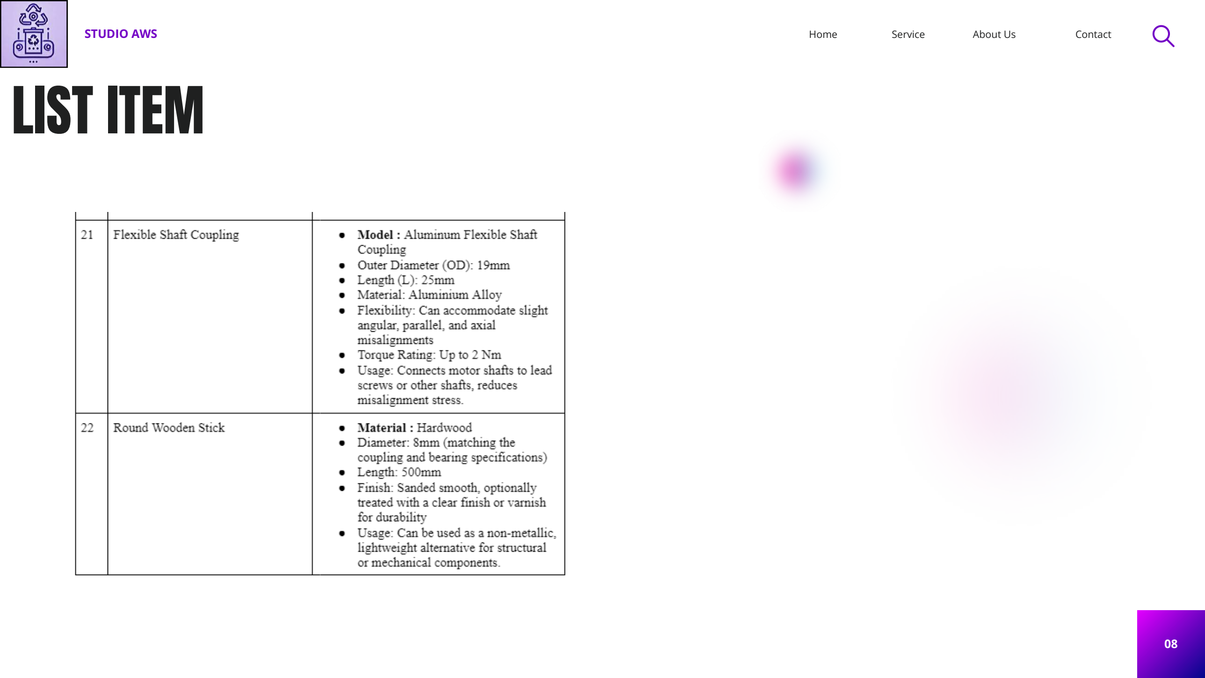
[picture p108: page 21]

Home | Service | About Us | Contact

08

# COSTING

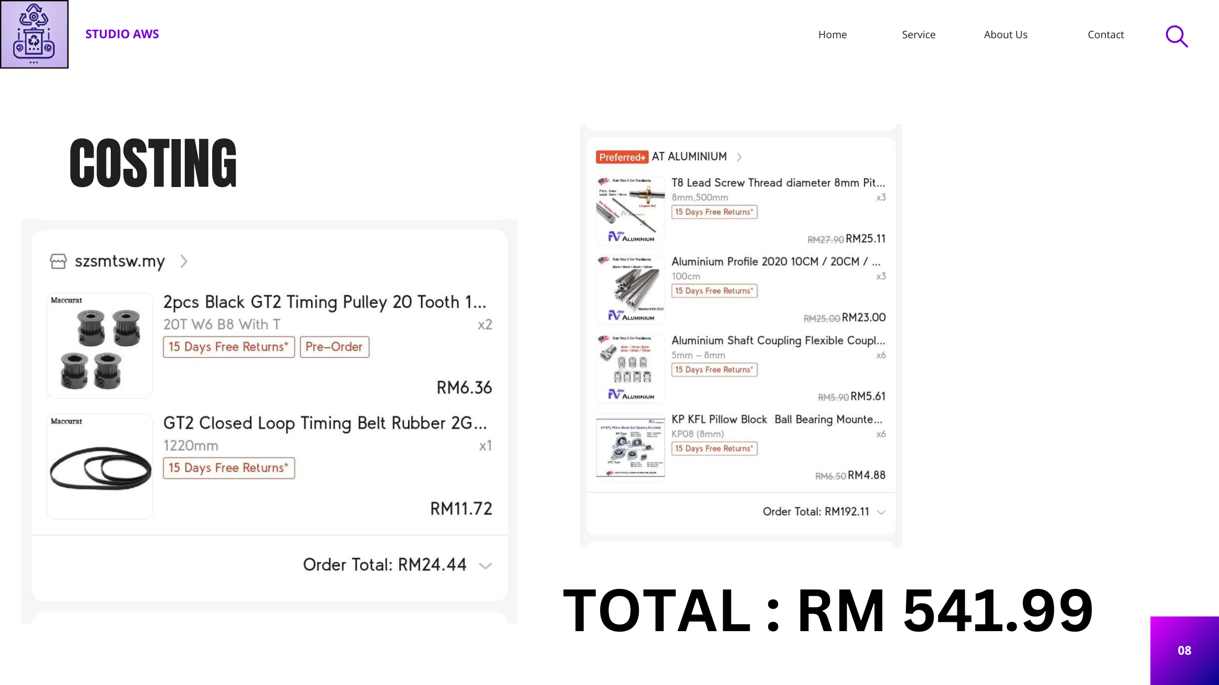
[picture p109: page 22]

Home | Service | About Us | Contact

08

# TOTAL : RM 541.99

# COSTING

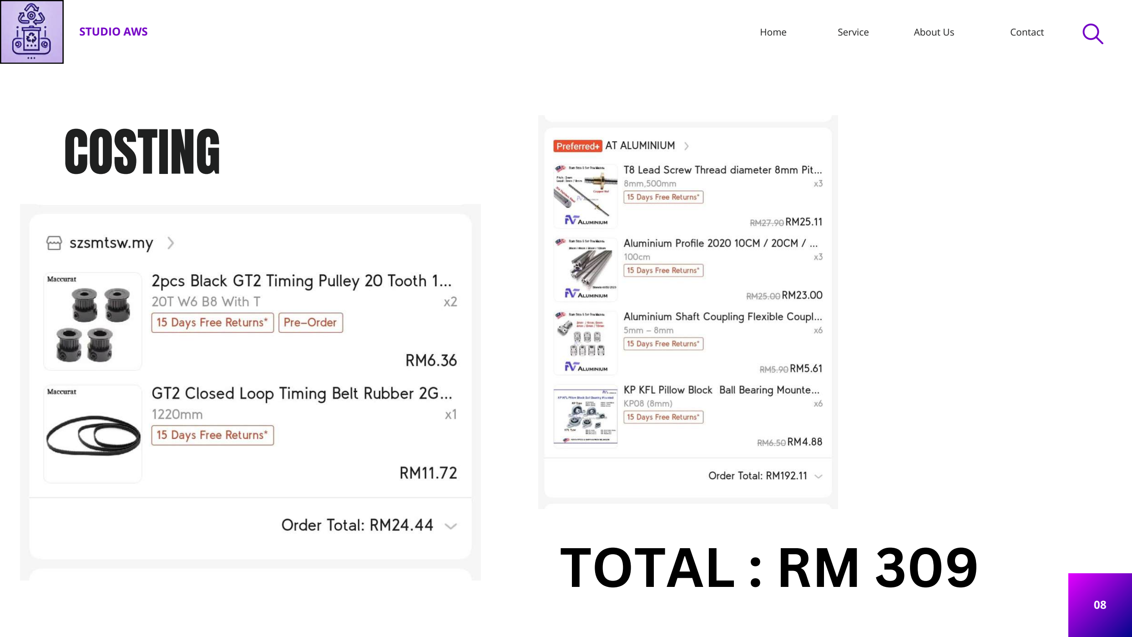
[picture p110: page 23]

Home | Service | About Us | Contact

08

# TOTAL : RM 309

# progression

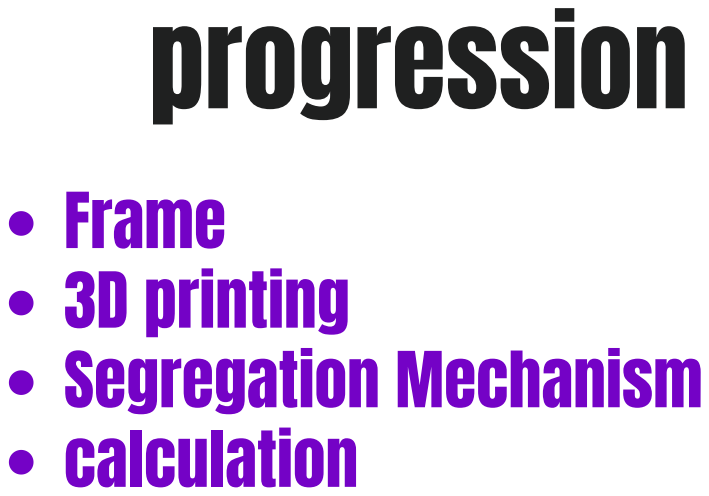
[picture p111: page 24]
Frame 3D printing Segregation Mechanism calculation

# 1. Frame

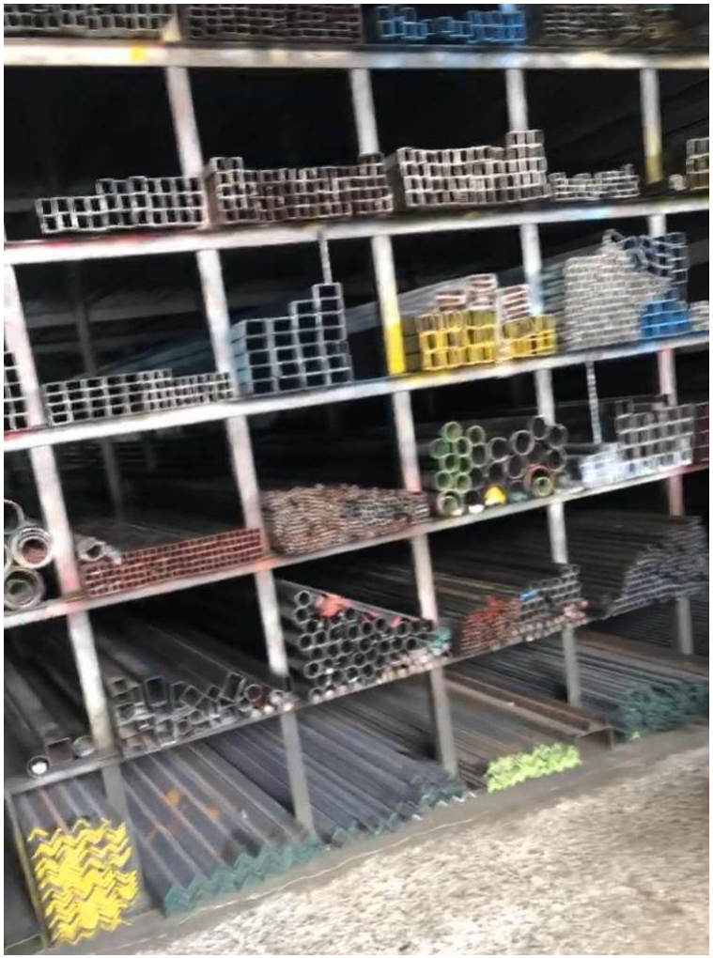
[picture p112: figure]

# Material: Stainless Steel 600mm x 600mm x 1000mm ( cuboid shape ) Thickness : 30mm x 30mm The whole main body

# 1.Measure Dimension

# frame processing

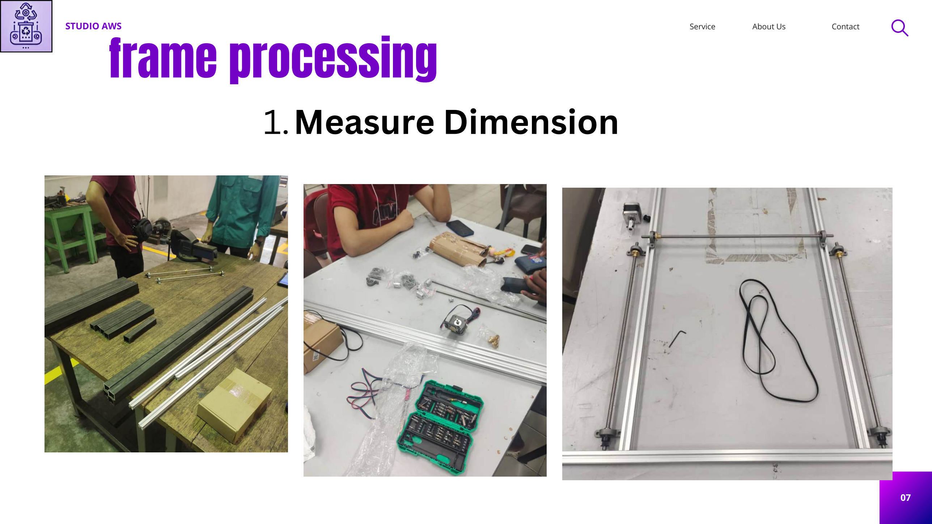
[picture p113: page 26]

# 2. Cutting & Welding Metal Components

# frame processing

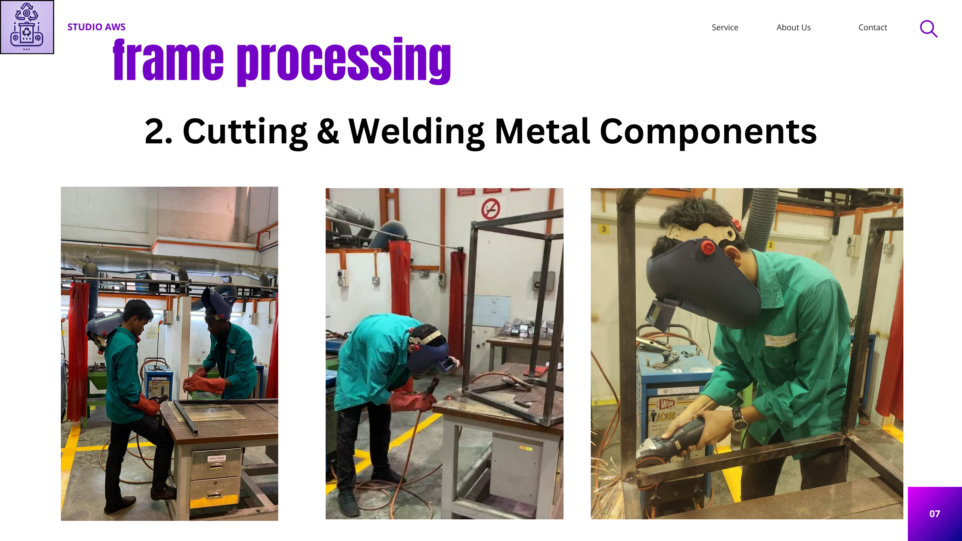
[picture p114: page 27]

# frame processing

# 2. Cutting & Welding Metal Components

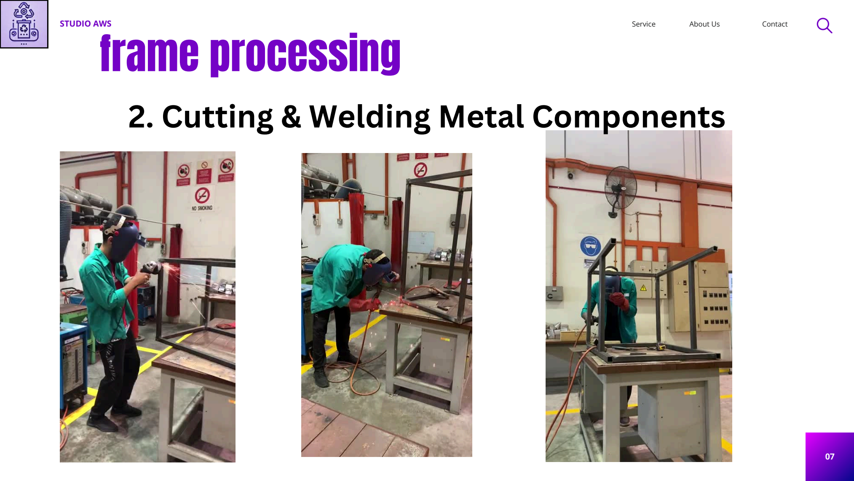
[picture p115: page 28]

# frame processing

# 3. final frame shape

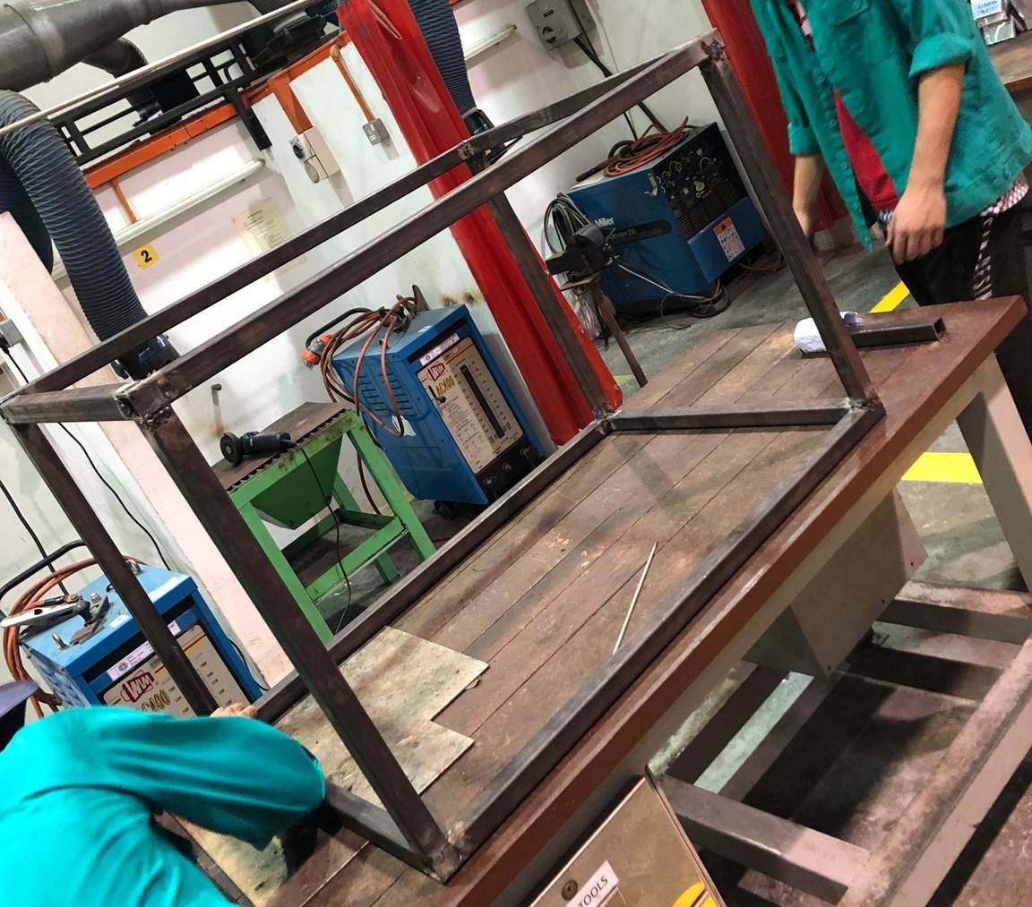
[picture p116: figure]

# 2. 3d printing Process

# supportings

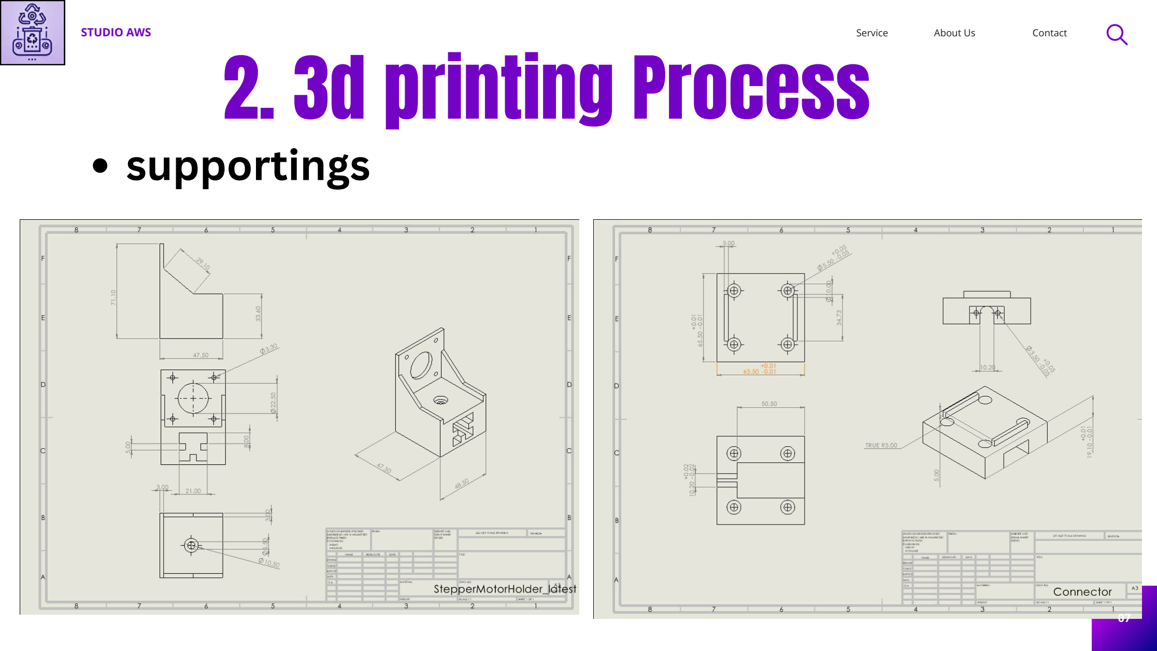
[picture p117: page 30]

# 2. 3d printing Process

# Final design

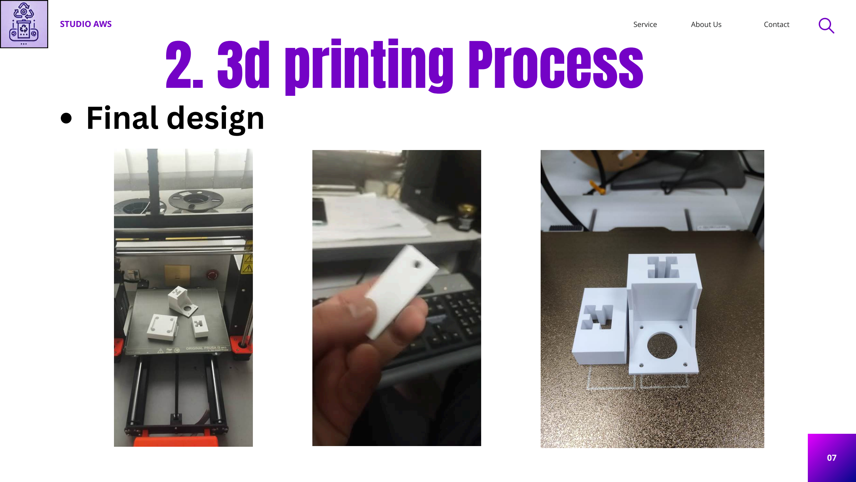
[picture p118: page 31]

# 3. Segregation Mechanism

# 1.Fabrication Process & Assembly Process

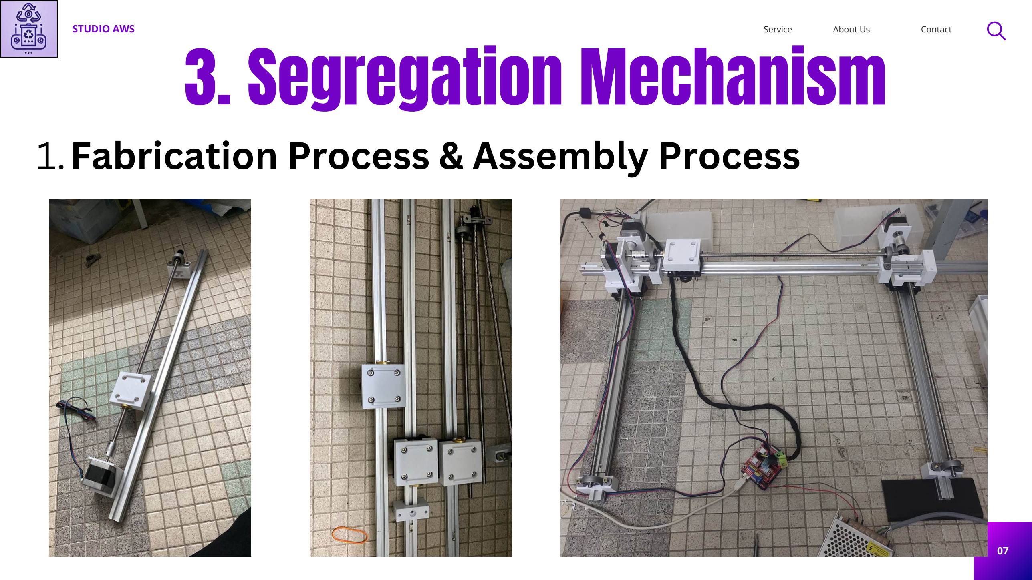
[picture p119: page 32]

# 2. Testing the Gantry system Process

# Segregation Mechanism

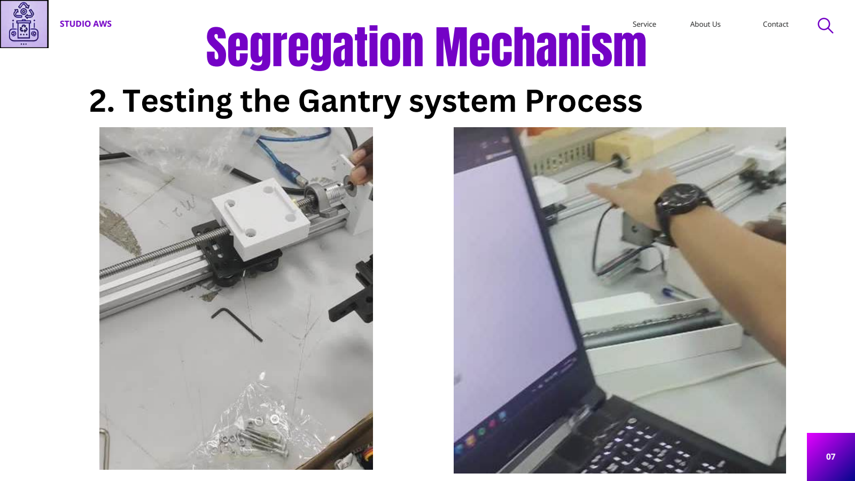
[picture p120: page 33]

# 4. Calculation

# 1. Load and Torque Calculation

# Key Considerations:

# 1.Motor Specifications: Torque rating of the NEMA 17 stepper motors (typically 0.4–0.5 Nm for standard

models at rated current).
Current and voltage supplied by the driver.

# 2.Mechanical Characteristics:

Lead screw pitch or belt pitch (linear movement per motor revolution). Friction and efficiency of the guide rails and transmission system.

# 3.System Configuration:

Total load supported by Motor C (including its own weight, load, and frame). Torque distribution on Motors A and B if they share the load.

# 4.Load Movement Steps:

Total steps to cover 5000 steps (as specified).

# Calculation

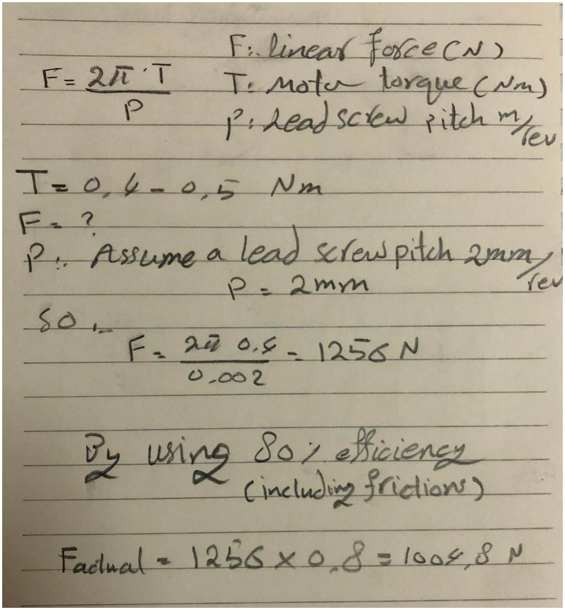
[picture p121: figure]

# Using the relationship between torque and linear

force on the leadscrew.

# The theoretical maximum force is applied by each motor before friction and

efficiency losses.

# Maximum focce

# Calculation

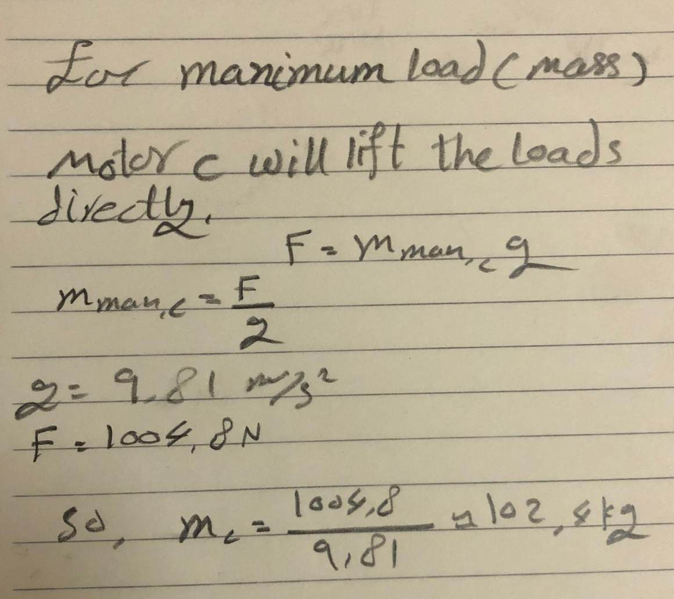
[picture p122: figure]

# If Motor C carries a smaller load (e.g., less than 102.4 kg), the total capacity

increases slightly.

# Maximum mass

# Calculation

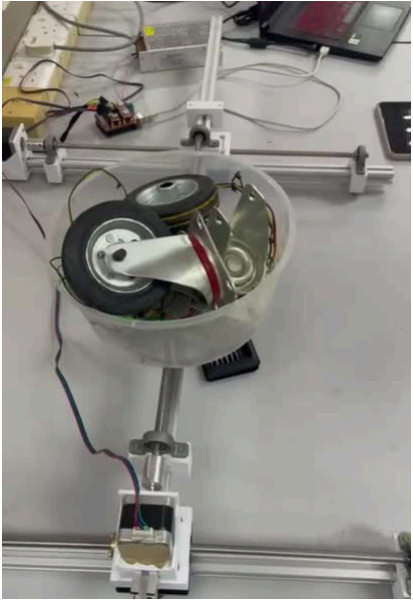
[picture p123: figure]

# testing 6kg of mass

# Calculation

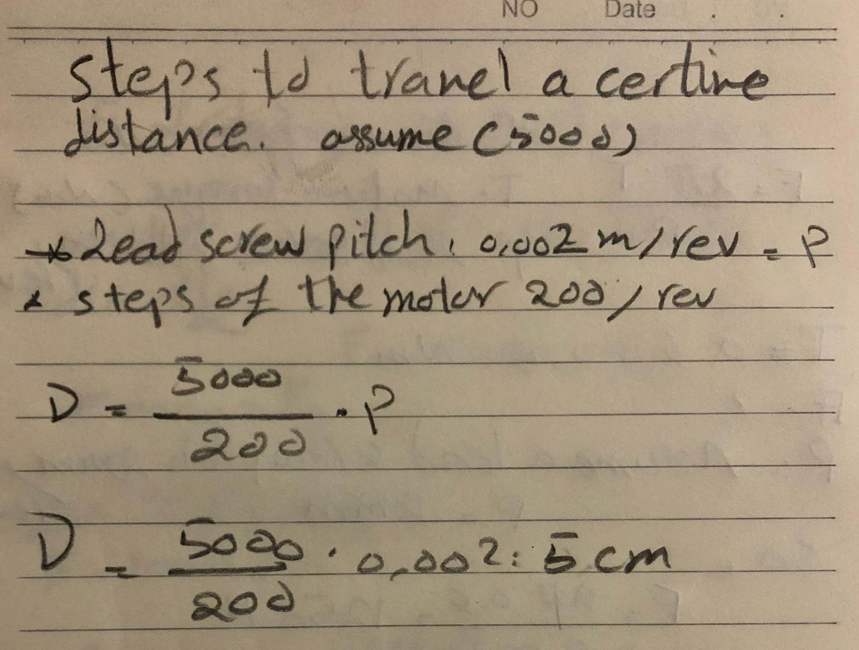
[picture p124: figure]

# Steps for a Require Travelling

# assume (5000) steps

# distance calculation

# Machine Learning

# Image Classification Using ML.NET in Visual Studio 2022 for Image Classification

# FLOW

# Mechanical Parts

# Preparing data set

# Train Data Set

# Evaluate Performance

# 1.Insert Dataset

# Machine Learning

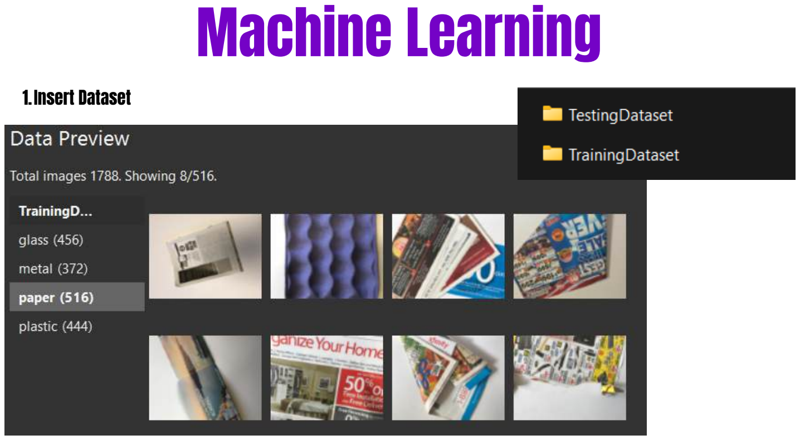
[picture p125: page 40]

# 2. Result by using this ML.Net Framework

# Machine Learning

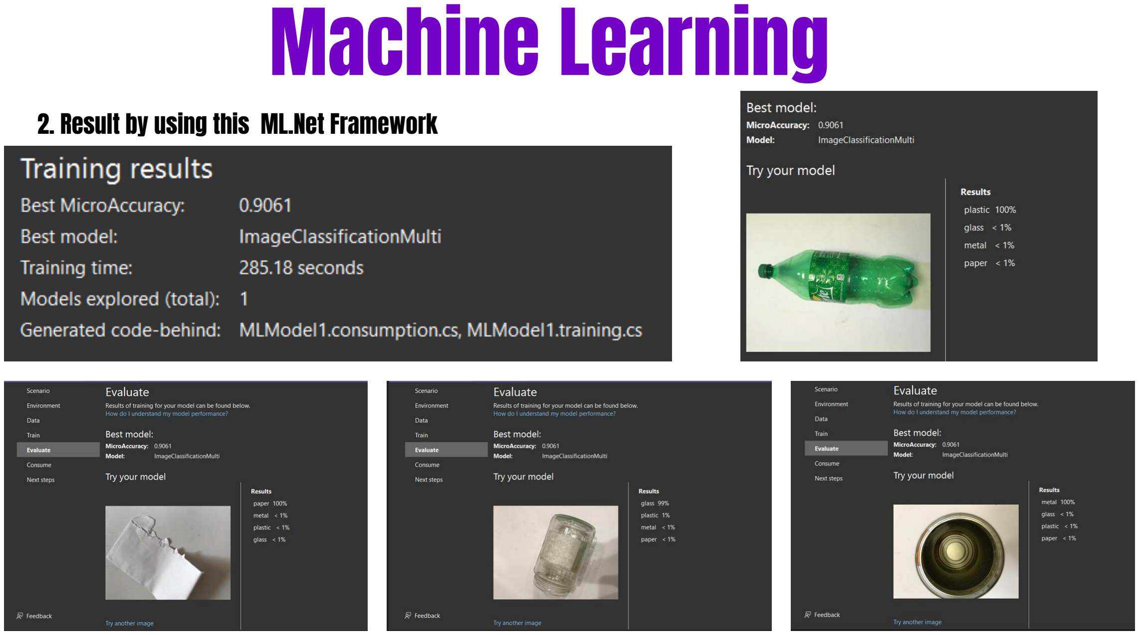
[picture p126: page 41]

# Machine Learning

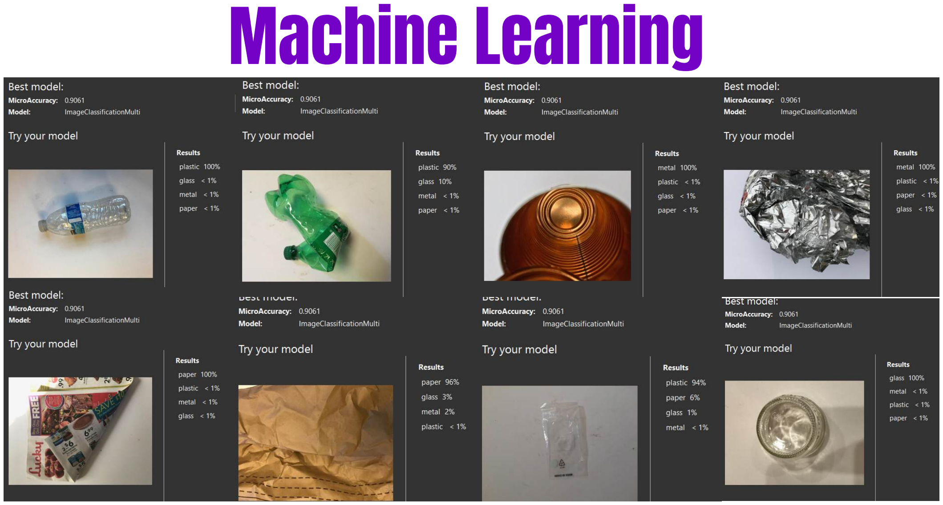
[picture p127: page 42]

# THANK

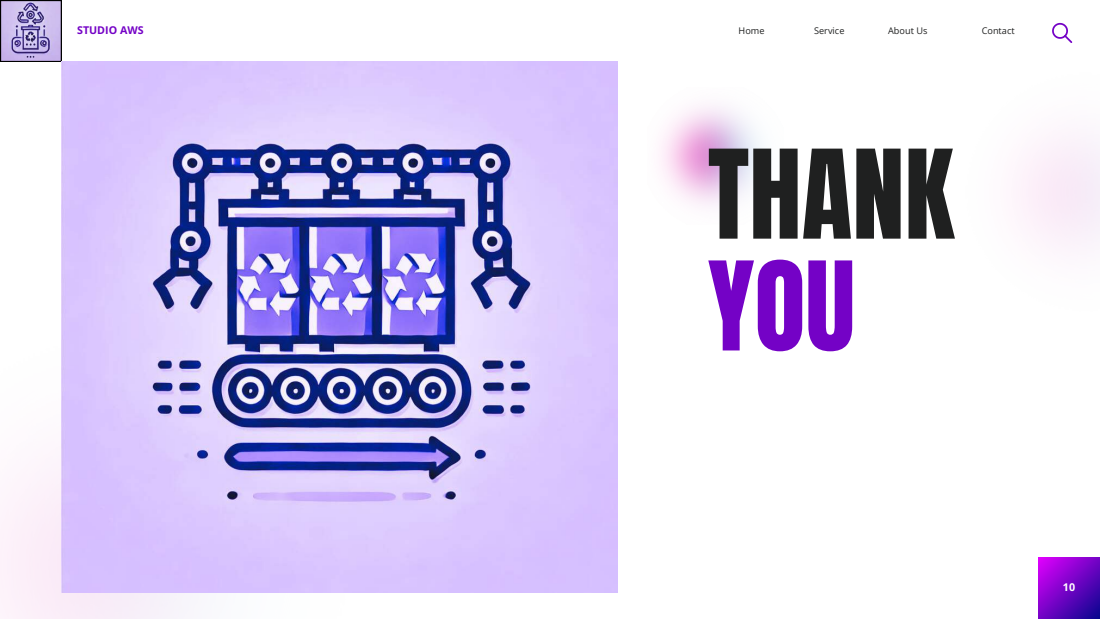
[picture p128: page 43]
Home; Service; About Us; Contact; YOU
