ibrahimnasrum/automatic-waste-segregation/3Ddrawing/Assembly Area 2.SLDASM

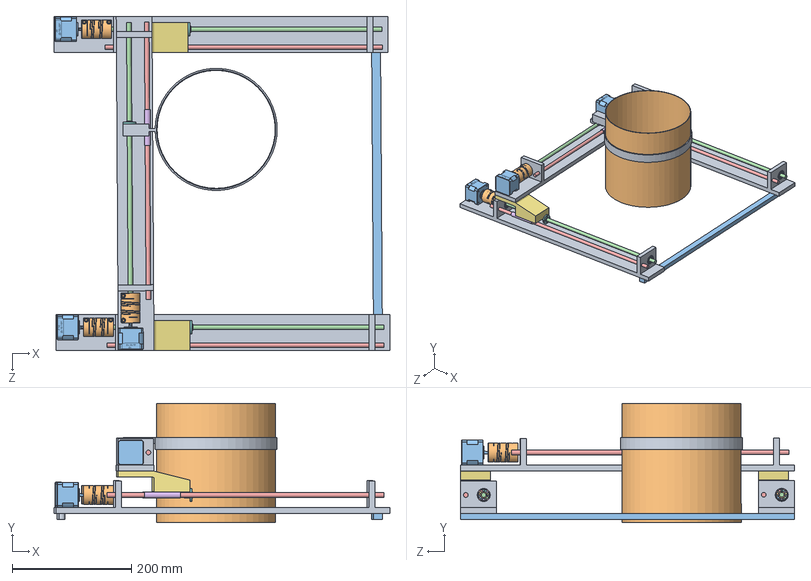
[picture p129: CAD file, 2026-01-03]
3Ddrawing/Assembly Area 2.SLDASM
563.2 x 200.1 x 560.4 mm
Papan Sebenar 10mmx45mmx560mm x 3
bb-608-a500-70-es_01 x 6
bb-608-a500-70-es_02 x 6
bb-608-a500-70-es_03 x 6
bb-608-a500-70-es_04 x 6
bb-608-a500-70-es_05 x 6
bb-608-a500-70-es_06 x 6
bb-608-a500-70-es_07 x 6
bb-608-a500-70-es_08 x 6
bb-608-a500-70-es_09 x 6
bb-608-a500-70-es_10 x 6
bb-608-a500-70-es_11 x 6
bb-608-a500-70-es_12 x 6
bb-608-a500-70-es_13 x 6
bb-608-a500-70-es_14 x 6
bb-608-a500-70-es_15 x 6
bb-608-a500-70-es_16 x 6
User Library-6208K582_ALUMINUM HELICAL FLEXIBLE SHAFT COUPLING x 3
ElectroCraft-TPE17-45A45-1100-0_TPE17-body x 3
Thread rod 500 mm x 3
CylinderWood x 3
SarungCylinderWood x 3
StandStepperMotor x 2
LeadScrew Nut 8mm x 2mmPitch x 3
Cylinder Holder
Cylinder Slot
Kayu extrude bulat tepi
