ibrahimnasrum/automatic-waste-segregation/3Ddrawing/Area 2 Stepper Motor - top.SLDASM

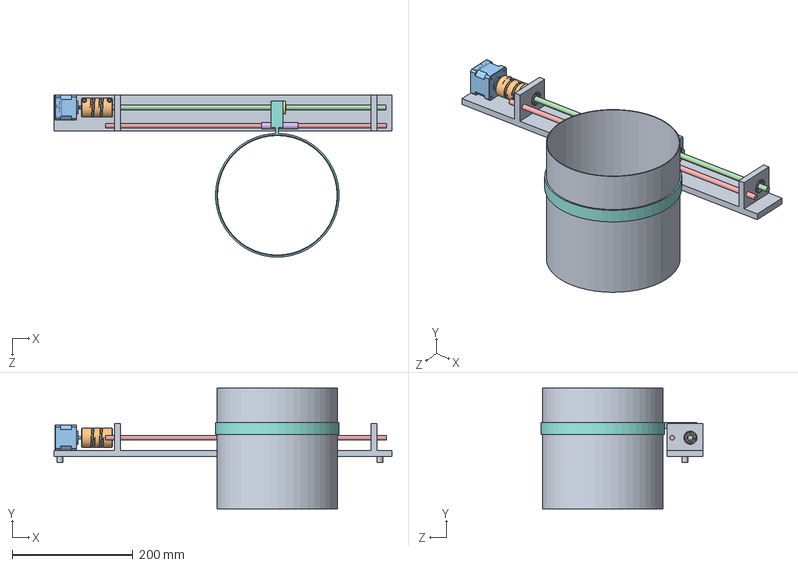
[picture p130: CAD file, 2026-01-03]
3Ddrawing/Area 2 Stepper Motor - top.SLDASM
560.0 x 200.0 x 269.0 mm
Papan Sebenar 10mmx45mmx560mm
bb-608-a500-70-es_01 x 2
bb-608-a500-70-es_02 x 2
bb-608-a500-70-es_03 x 2
bb-608-a500-70-es_04 x 2
bb-608-a500-70-es_05 x 2
bb-608-a500-70-es_06 x 2
bb-608-a500-70-es_07 x 2
bb-608-a500-70-es_08 x 2
bb-608-a500-70-es_09 x 2
bb-608-a500-70-es_10 x 2
bb-608-a500-70-es_11 x 2
bb-608-a500-70-es_12 x 2
bb-608-a500-70-es_13 x 2
bb-608-a500-70-es_14 x 2
bb-608-a500-70-es_15 x 2
bb-608-a500-70-es_16 x 2
User Library-6208K582_ALUMINUM HELICAL FLEXIBLE SHAFT COUPLING
ElectroCraft-TPE17-45A45-1100-0_TPE17-body
Thread rod 500 mm
CylinderWood
SarungCylinderWood
LeadScrew Nut 8mm x 2mmPitch
Cylinder Holder
Cylinder Slot
