ibrahimnasrum/automatic-waste-segregation/3Ddrawing/StandnNut - Assembly1.SLDASM

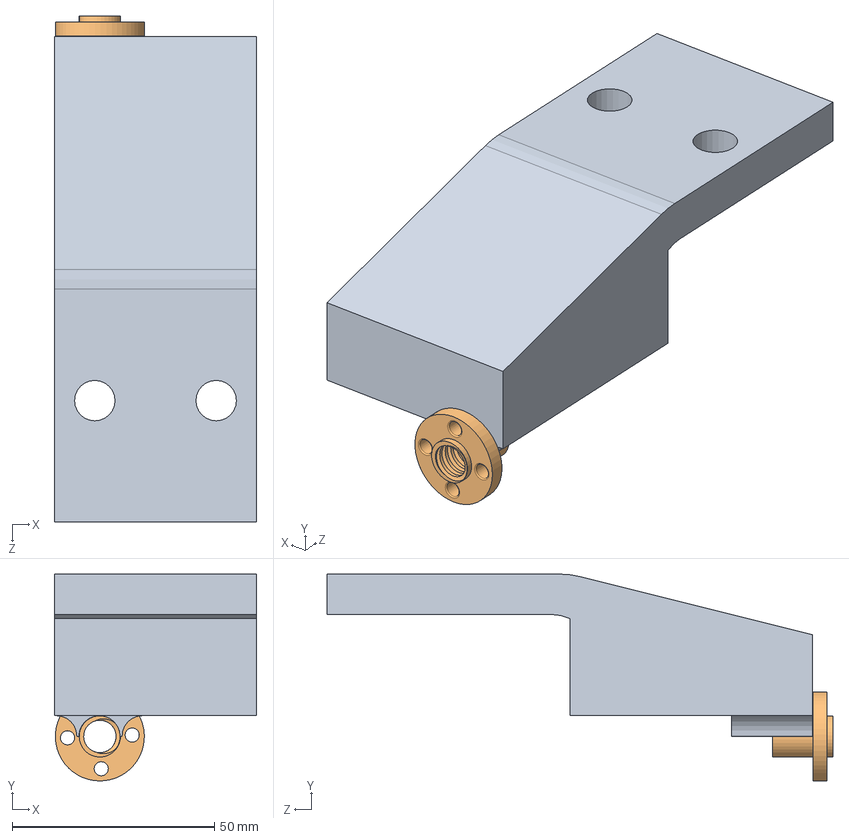
[picture p133: CAD file, 2026-01-03]
3Ddrawing/StandnNut - Assembly1.SLDASM
50.0 x 51.1 x 125.0 mm
StandStepperMotor
LeadScrew Nut 8mm x 2mmPitch
