ibrahimnasrum/automatic-waste-segregation/3Ddrawing/Plug.SLDPRT

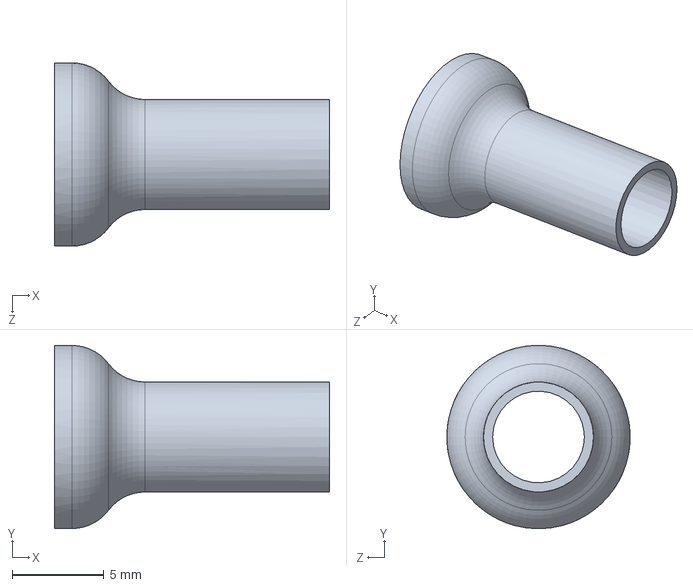
[picture p134: CAD file, 2026-01-03]
3Ddrawing/Plug.SLDPRT
15.0 x 10.0 x 10.0 mm
