ibrahimnasrum/automatic-waste-segregation/3Ddrawing/kayu 10mmx10mm.SLDPRT

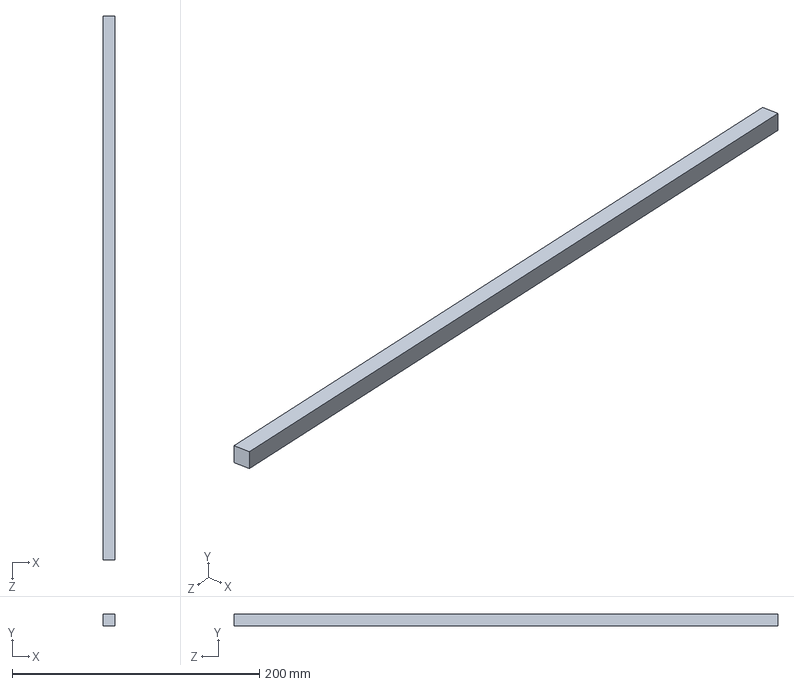
[picture p135: CAD file, 2026-01-03]
3Ddrawing/kayu 10mmx10mm.SLDPRT
10.0 x 10.0 x 440.0 mm
