ibrahimnasrum/automatic-waste-segregation/3Ddrawing/Kayu extrude bulat tepi.SLDPRT

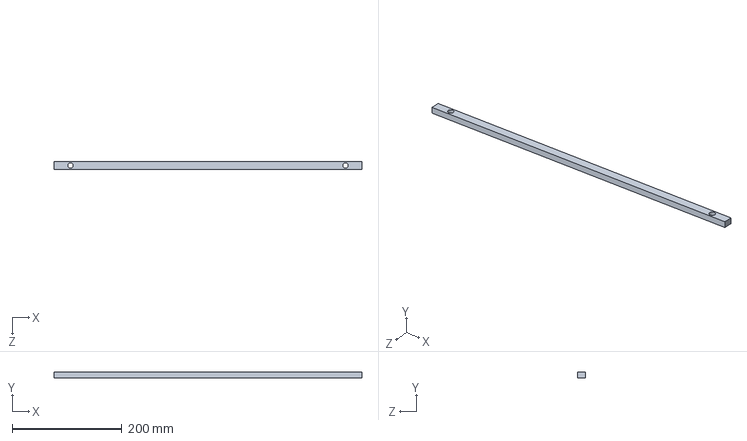
[picture p136: CAD file, 2026-01-03]
3Ddrawing/Kayu extrude bulat tepi.SLDPRT
560.0 x 10.0 x 15.0 mm
