ibrahimnasrum/automatic-waste-segregation/3Ddrawing/Papan 10mmx45mmx560mm.SLDPRT

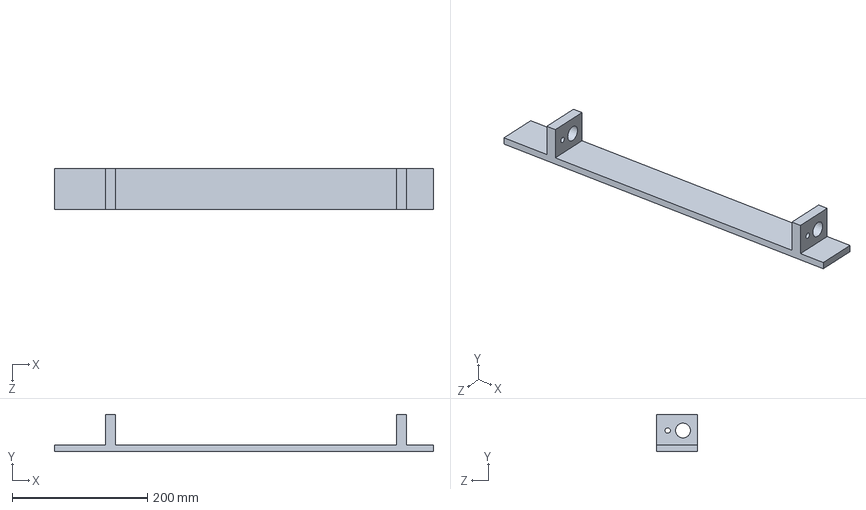
[picture p137: CAD file, 2026-01-03]
3Ddrawing/Papan 10mmx45mmx560mm.SLDPRT
560.0 x 55.0 x 60.0 mm
