ibrahimnasrum/automatic-waste-segregation/3Ddrawing/StandStepperMotor.SLDPRT

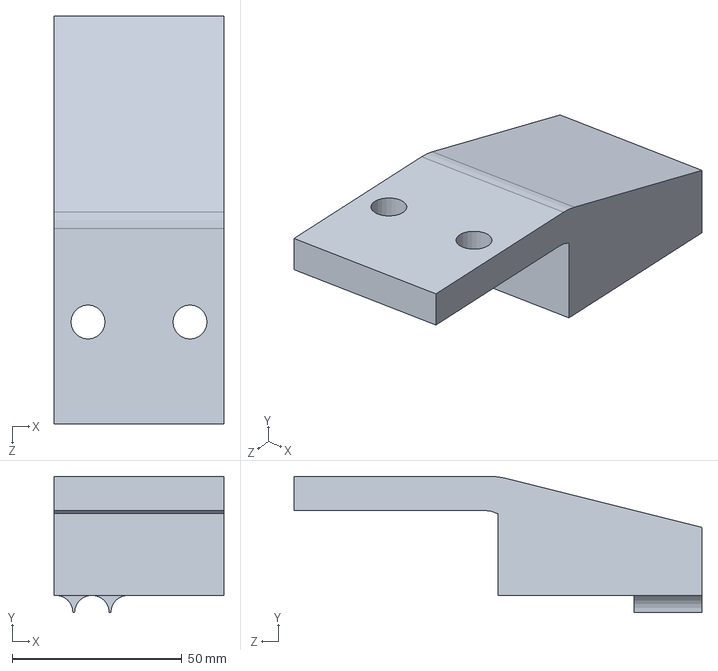
[picture p138: CAD file, 2026-01-03]
3Ddrawing/StandStepperMotor.SLDPRT
50.0 x 40.1 x 120.0 mm
