ibrahimnasrum/automatic-waste-segregation/3Ddrawing/Automatic Waste Segregation.SLDPRT

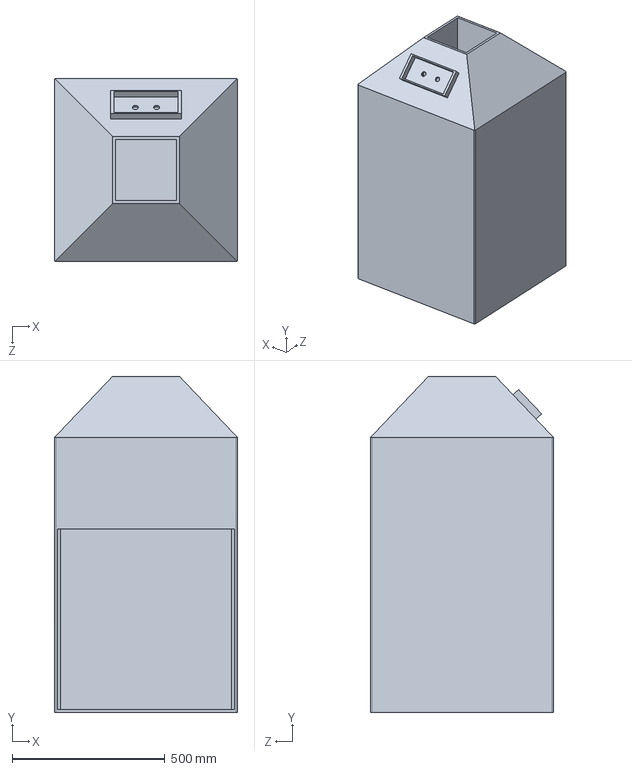
[picture p139: CAD file, 2026-01-03]
3Ddrawing/Automatic Waste Segregation.SLDPRT
600.0 x 1100.0 x 600.0 mm
