ibrahimnasrum/automatic-waste-segregation/3Ddrawing/Papan Sebenar 10mmx45mmx560mm.SLDPRT

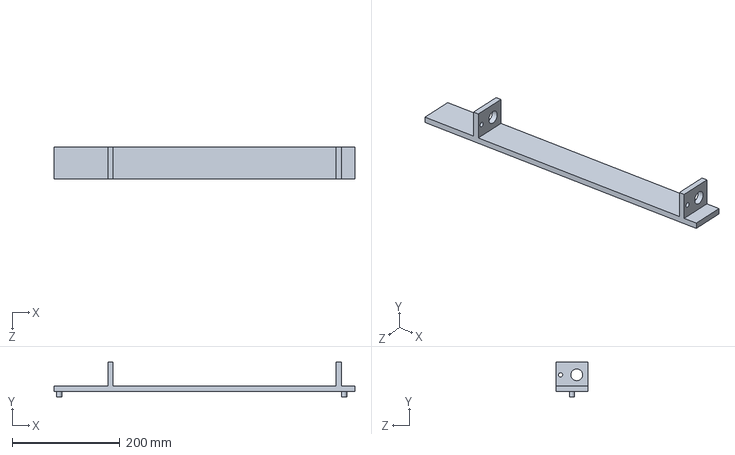
[picture p140: CAD file, 2026-01-03]
3Ddrawing/Papan Sebenar 10mmx45mmx560mm.SLDPRT
560.0 x 65.0 x 60.0 mm
