ibrahimnasrum/automatic-waste-segregation/3Ddrawing/CylinderWood.SLDPRT

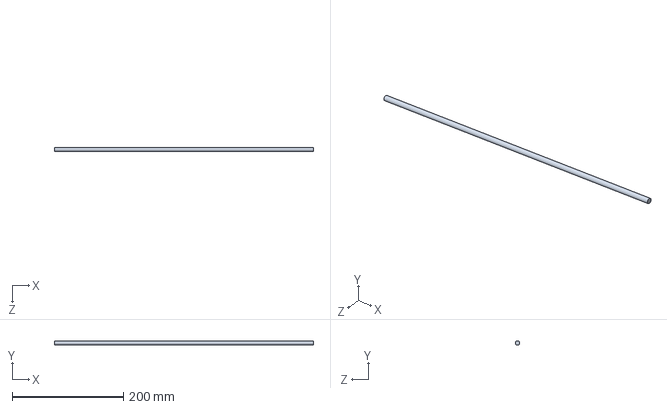
[picture p141: CAD file, 2026-01-03]
3Ddrawing/CylinderWood.SLDPRT
465.0 x 8.00 x 8.00 mm
