ibrahimnasrum/automatic-waste-segregation/3Ddrawing/Automatic Waste Segregation Storage.SLDPRT

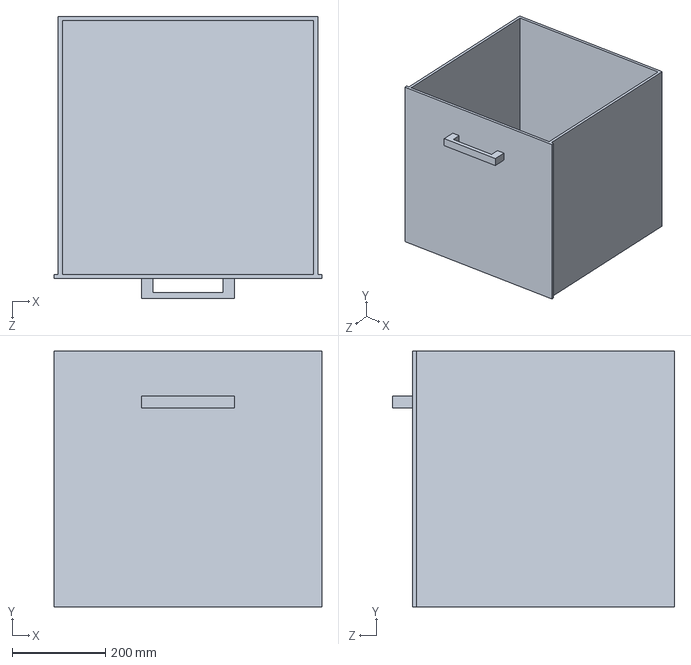
[picture p142: CAD file, 2026-01-03]
3Ddrawing/Automatic Waste Segregation Storage.SLDPRT
576.0 x 550.0 x 607.0 mm
