ibrahimnasrum/automatic-waste-segregation/3Ddrawing/Cylinder Slot.SLDPRT

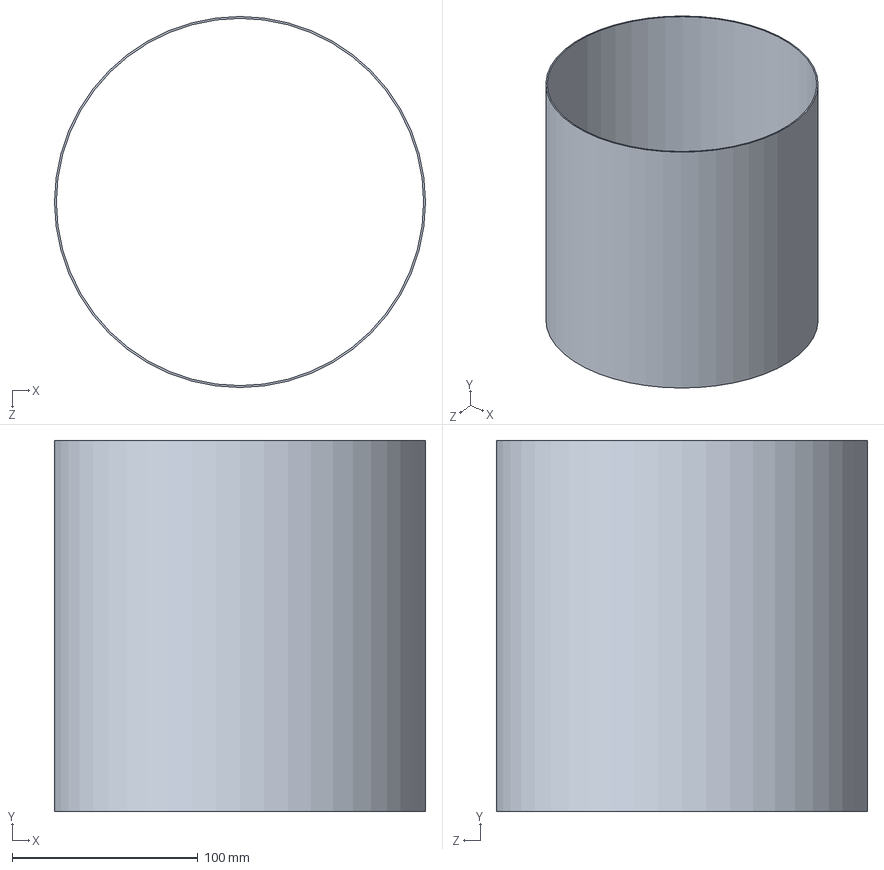
[picture p143: CAD file, 2026-01-03]
3Ddrawing/Cylinder Slot.SLDPRT
200.0 x 200.0 x 200.0 mm
