ibrahimnasrum/automatic-waste-segregation/3Ddrawing/SarungCylinderWood.SLDPRT

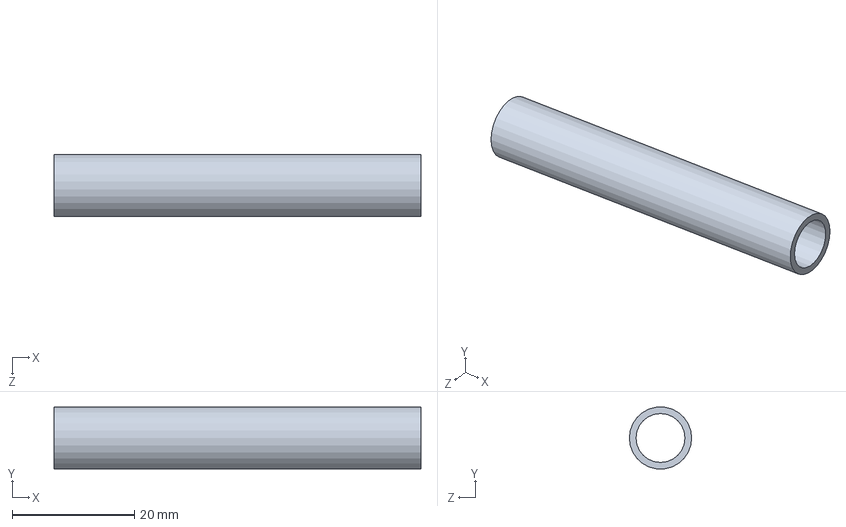
[picture p144: CAD file, 2026-01-03]
3Ddrawing/SarungCylinderWood.SLDPRT
60.0 x 10.1 x 10.2 mm
