ibrahimnasrum/automatic-waste-segregation/3Ddrawing/Cylinder Holder.SLDPRT

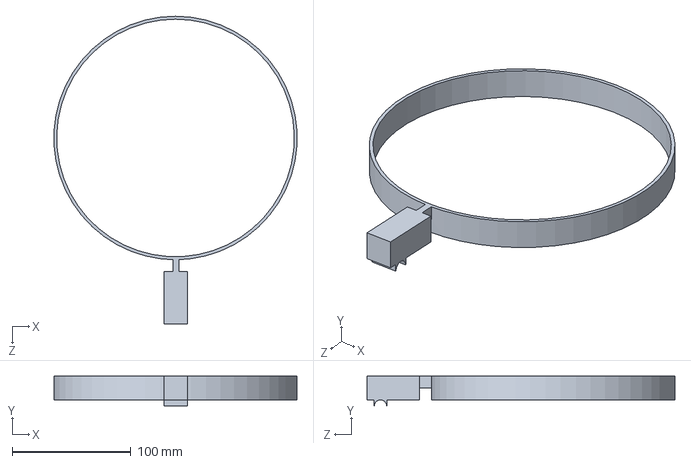
[picture p145: CAD file, 2026-01-03]
3Ddrawing/Cylinder Holder.SLDPRT
204.6 x 25.1 x 259.0 mm
