ibrahimnasrum/automatic-waste-segregation/3Ddrawing/LeadScrew Nut 8mm x 2mmPitch.SLDPRT

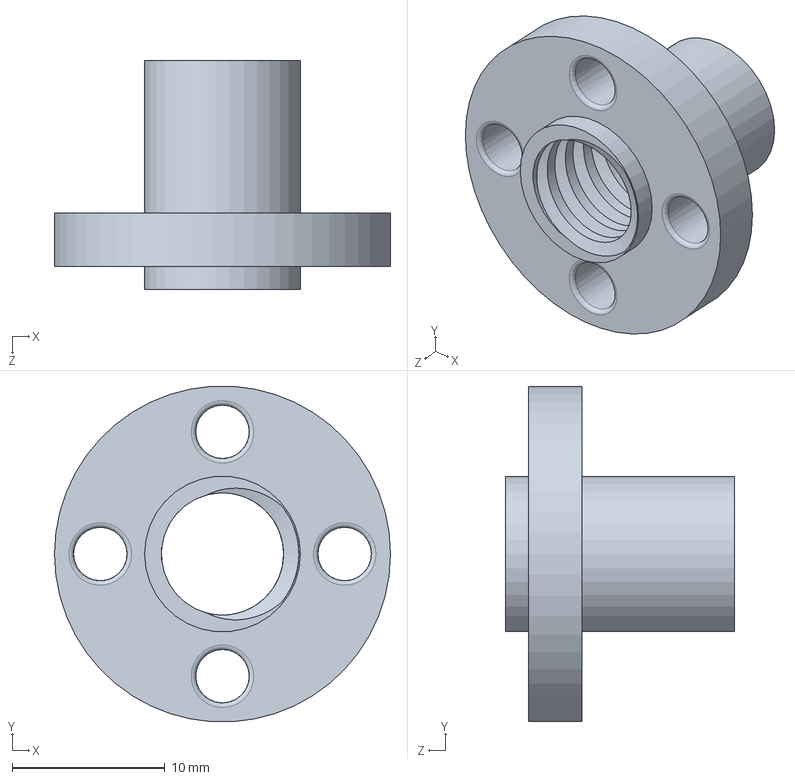
[picture p146: CAD file, 2026-01-03]
3Ddrawing/LeadScrew Nut 8mm x 2mmPitch.SLDPRT
22.0 x 22.0 x 15.0 mm
