ibrahimnasrum/automatic-waste-segregation/(list of files, cad)

Other CAD files:
3Ddrawing/Area 2 Stepper Motor.SLDDRW
3Ddrawing/Assembly Area 2.SLDDRW
3Ddrawing/Automatic Waste Segregation Storage.SLDDRW
3Ddrawing/Automatic Waste Segregation.SLDDRW
3Ddrawing/Cylinder Holder.SLDDRW
